TDT4295AForEffort/pcb/components/crystal/CX3225SB48000D0FFFCC.step

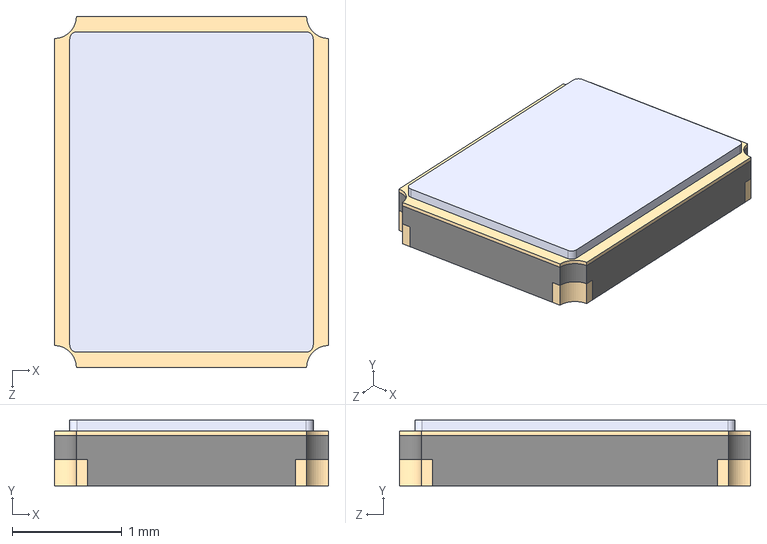
[picture p1: CAD file, 2022-09-29]
components/crystal/CX3225SB48000D0FFFCC.step
2.50 x 0.6 x 3.20 mm
