TDT4295AForEffort/pcb/components/debug_header/FTSH-110-01-L-DV-007.step

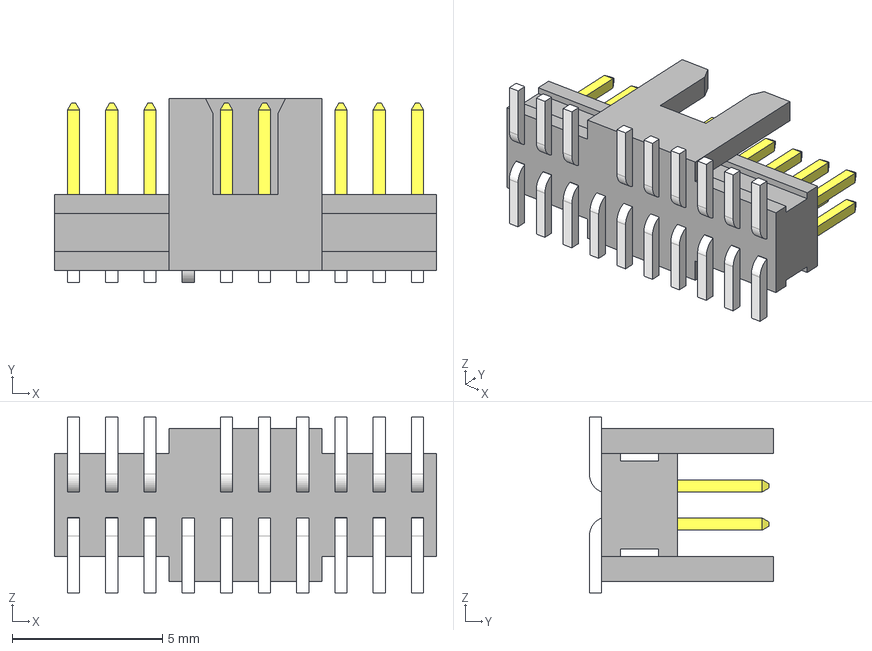
[picture p2: CAD file, 2022-09-29]
components/debug_header/FTSH-110-01-L-DV-007.step
12.7 x 6.12 x 5.84 mm
FTSH-110-01-L-DV-007-K_pins2
FTSH-110-01-L-DV-007-K_pins1
FTSH-110-01-L-DV-007-K_body
