TDT4295AForEffort/pcb/pcb/pcb.kicad_pcb

## KiCad design pcb/pcb.kicad_pcb (2022-10-04)

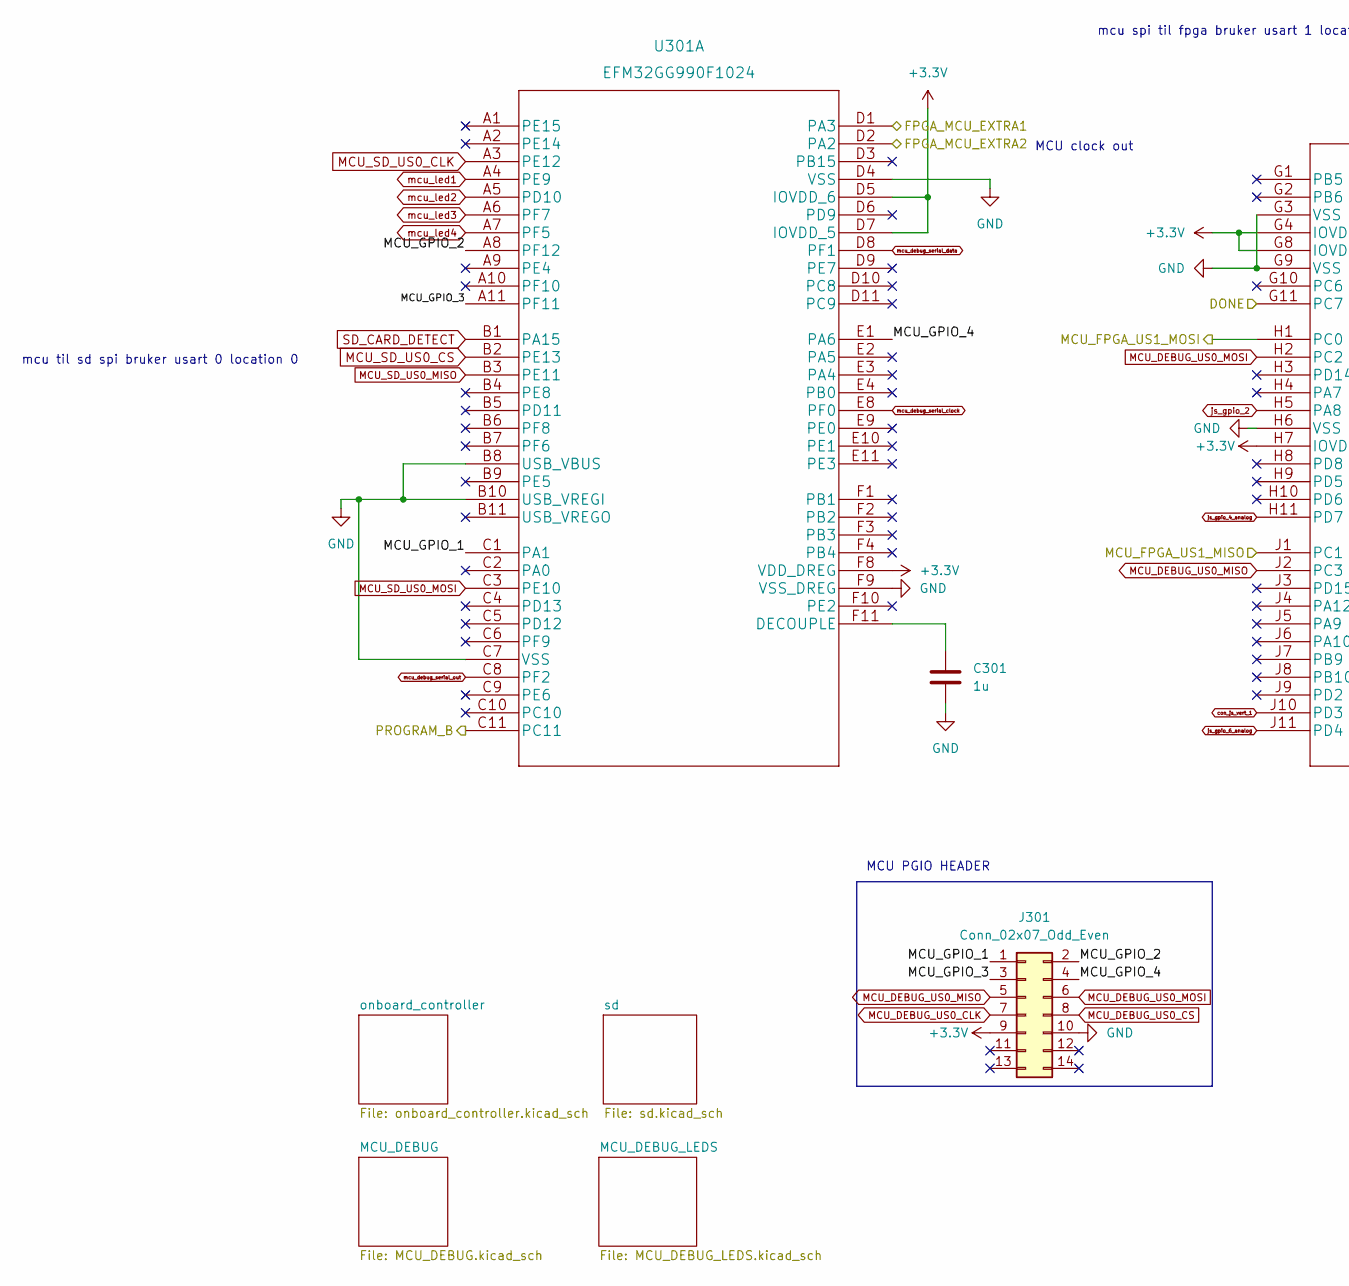
[picture p3: schematic mcu.kicad_sch, part in row 1, column 1]

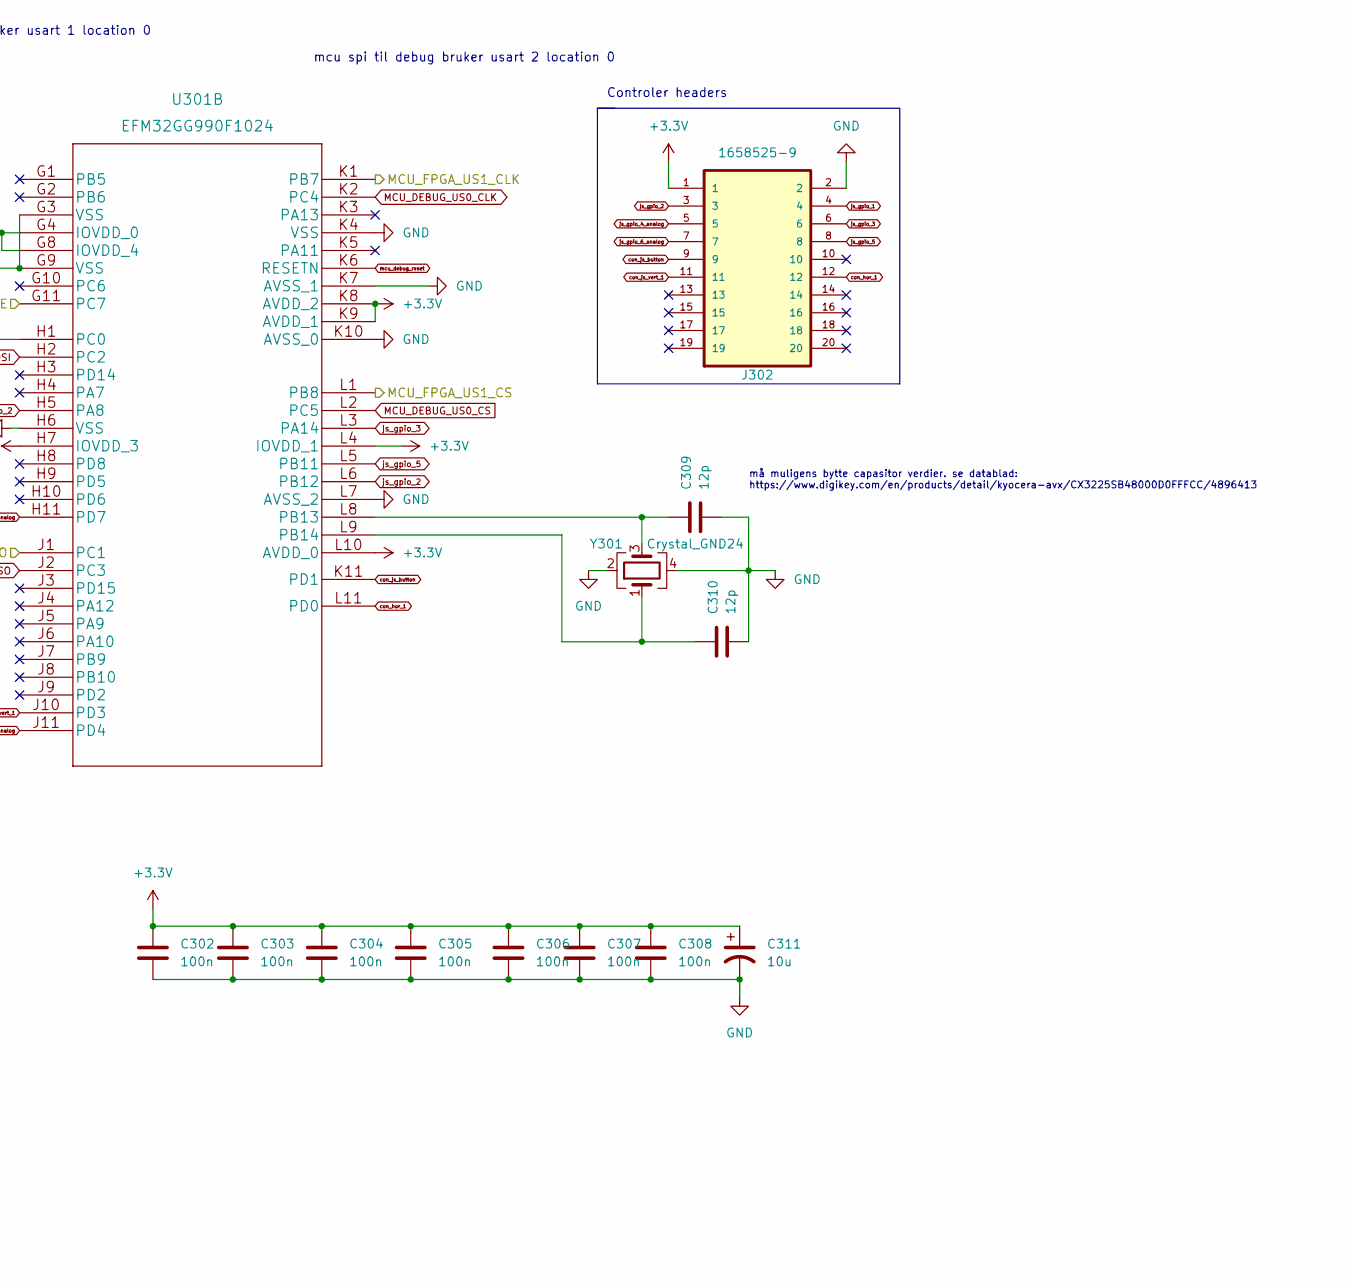
[picture p4: schematic mcu.kicad_sch, part in row 1, column 2]

Parts:
C301: 1u; C_0805_2012Metric_Pad1.18x1.45mm_HandSolder
C302, C303, C304, C305, C306, C307, C308: 100n; C_0805_2012Metric_Pad1.18x1.45mm_HandSolder
C309, C310: 12p; C_0603_1608Metric_Pad1.08x0.95mm_HandSolder
C311: 10u; C_0805_2012Metric_Pad1.18x1.45mm_HandSolder
J301: Conn_02x07_Odd_Even; PinHeader_2x07_P2.54mm_Vertical
J302: 1658525-9; TE_1658525-9
U301: EFM32GG990F1024
Y301: Crystal_GND24; OSC_ECS-2520S25-250-FN-TR

Connections:
+3.3V: C302.1, C303.1, C304.1, C305.1, C306.1, C307.1, C308.1, C311.1, J301.9, J302.1, U301.D5 (IOVDD_6), U301.D7 (IOVDD_5), U301.F8 (VDD_DREG), U301.G4 (IOVDD_0), U301.G8 (IOVDD_4), U301.H7 (IOVDD_3), U301.K8 (AVDD_2), U301.K9 (AVDD_1), U301.L4 (IOVDD_1), U301.L10 (AVDD_0); also elsewhere on the board
/Mcu/MCU_GPIO_1: J301.1, U301.C1 (PA1)
/Mcu/MCU_GPIO_2: J301.2, U301.A8 (PF12)
/Mcu/MCU_GPIO_3: J301.3, U301.A11 (PF11)
/Mcu/MCU_GPIO_4: J301.4, U301.E1 (PA6)
FGPA_MCU_EXTRA1: U301.D1 (PA3); also elsewhere on the board
FGPA_MCU_EXTRA2: U301.D2 (PA2); also elsewhere on the board
FGPA_MCU_SPI_CLK: U301.K1 (PB7); also elsewhere on the board
FGPA_MCU_SPI_CS: U301.L1 (PB8); also elsewhere on the board
FGPA_MCU_SPI_SDI: U301.H1 (PC0); also elsewhere on the board
FGPA_MCU_SPI_SDO: U301.J1 (PC1); also elsewhere on the board
FPGA_DONE: U301.G11 (PC7); also elsewhere on the board
FPGA_PROGRAM_B: U301.C11; also elsewhere on the board
GND: C301.2, C302.2, C303.2, C304.2, C305.2, C306.2, C307.2, C308.2, C309.2, C310.2, C311.2, J301.10, J302.2, U301.B8 (USB_VBUS), U301.B10 (USB_VREGI), U301.C7 (VSS), U301.D4 (VSS), U301.F9 (VSS_DREG), U301.G3 (VSS), U301.G9 (VSS), U301.H6 (VSS), U301.K4 (VSS), U301.K7 (AVSS_1), U301.K10 (AVSS_0), U301.L7 (AVSS_2), Y301.2, Y301.4; also elsewhere on the board
MCU_DEBUG_US0_CLK: J301.7, U301.K2 (PC4)
MCU_DEBUG_US0_CS: J301.8, U301.L2 (PC5)
MCU_DEBUG_US0_MISO: J301.5, U301.J2 (PC3)
MCU_DEBUG_US0_MOSI: J301.6, U301.H2 (PC2)
MCU_SD_US0_CLK: U301.A3 (PE12); also elsewhere on the board
MCU_SD_US0_CS: U301.B2 (PE13); also elsewhere on the board
MCU_SD_US0_MISO: U301.B3 (PE11); also elsewhere on the board
MCU_SD_US0_MOSI: U301.C3 (PE10); also elsewhere on the board
unnamed: C301.1, U301.F11 (DECOUPLE)
unnamed: C309.1, U301.L8 (PB13), Y301.3
unnamed: C310.1, U301.L9 (PB14), Y301.1
SD_CARD_DETECT: U301.B1 (PA15); also elsewhere on the board
con_hor_1: J302.12, U301.L11 (PD0)
con_js_button: J302.9, U301.K11 (PD1)
con_js_vert_1: J302.11, U301.J10 (PD3)
js_gpio_3: J302.6, U301.L3 (PA14)
js_gpio_4_analog: J302.5, U301.H11 (PD7)
js_gpio_5: J302.8, U301.L5 (PB11)
js_gpio_6_analog: J302.7, U301.J11 (PD4)
mcu_debug_reset: U301.K6 (RESETN); also elsewhere on the board
mcu_debug_serial_clock: U301.E8 (PF0); also elsewhere on the board
mcu_debug_serial_data: U301.D8 (PF1); also elsewhere on the board
mcu_debug_serial_out: U301.C8 (PF2); also elsewhere on the board
mcu_led1: U301.A4 (PE9); also elsewhere on the board
mcu_led2: U301.A5 (PD10); also elsewhere on the board
mcu_led3: U301.A6 (PF7); also elsewhere on the board
mcu_led4: U301.A7 (PF5); also elsewhere on the board

Notes on the sheet:
mcu til sd spi bruker usart 0 location 0
MCU PGIO HEADER
mcu spi til debug bruker usart 2 location 0
Controler headers
må muligens bytte capasitor verdier. se datablad: https://www.digikey.com/en/products/detail/kyocera-avx/CX3225SB48000D0FFFCC/4896413
MCU clock out
mcu spi til fpga bruker usart 1 location 0

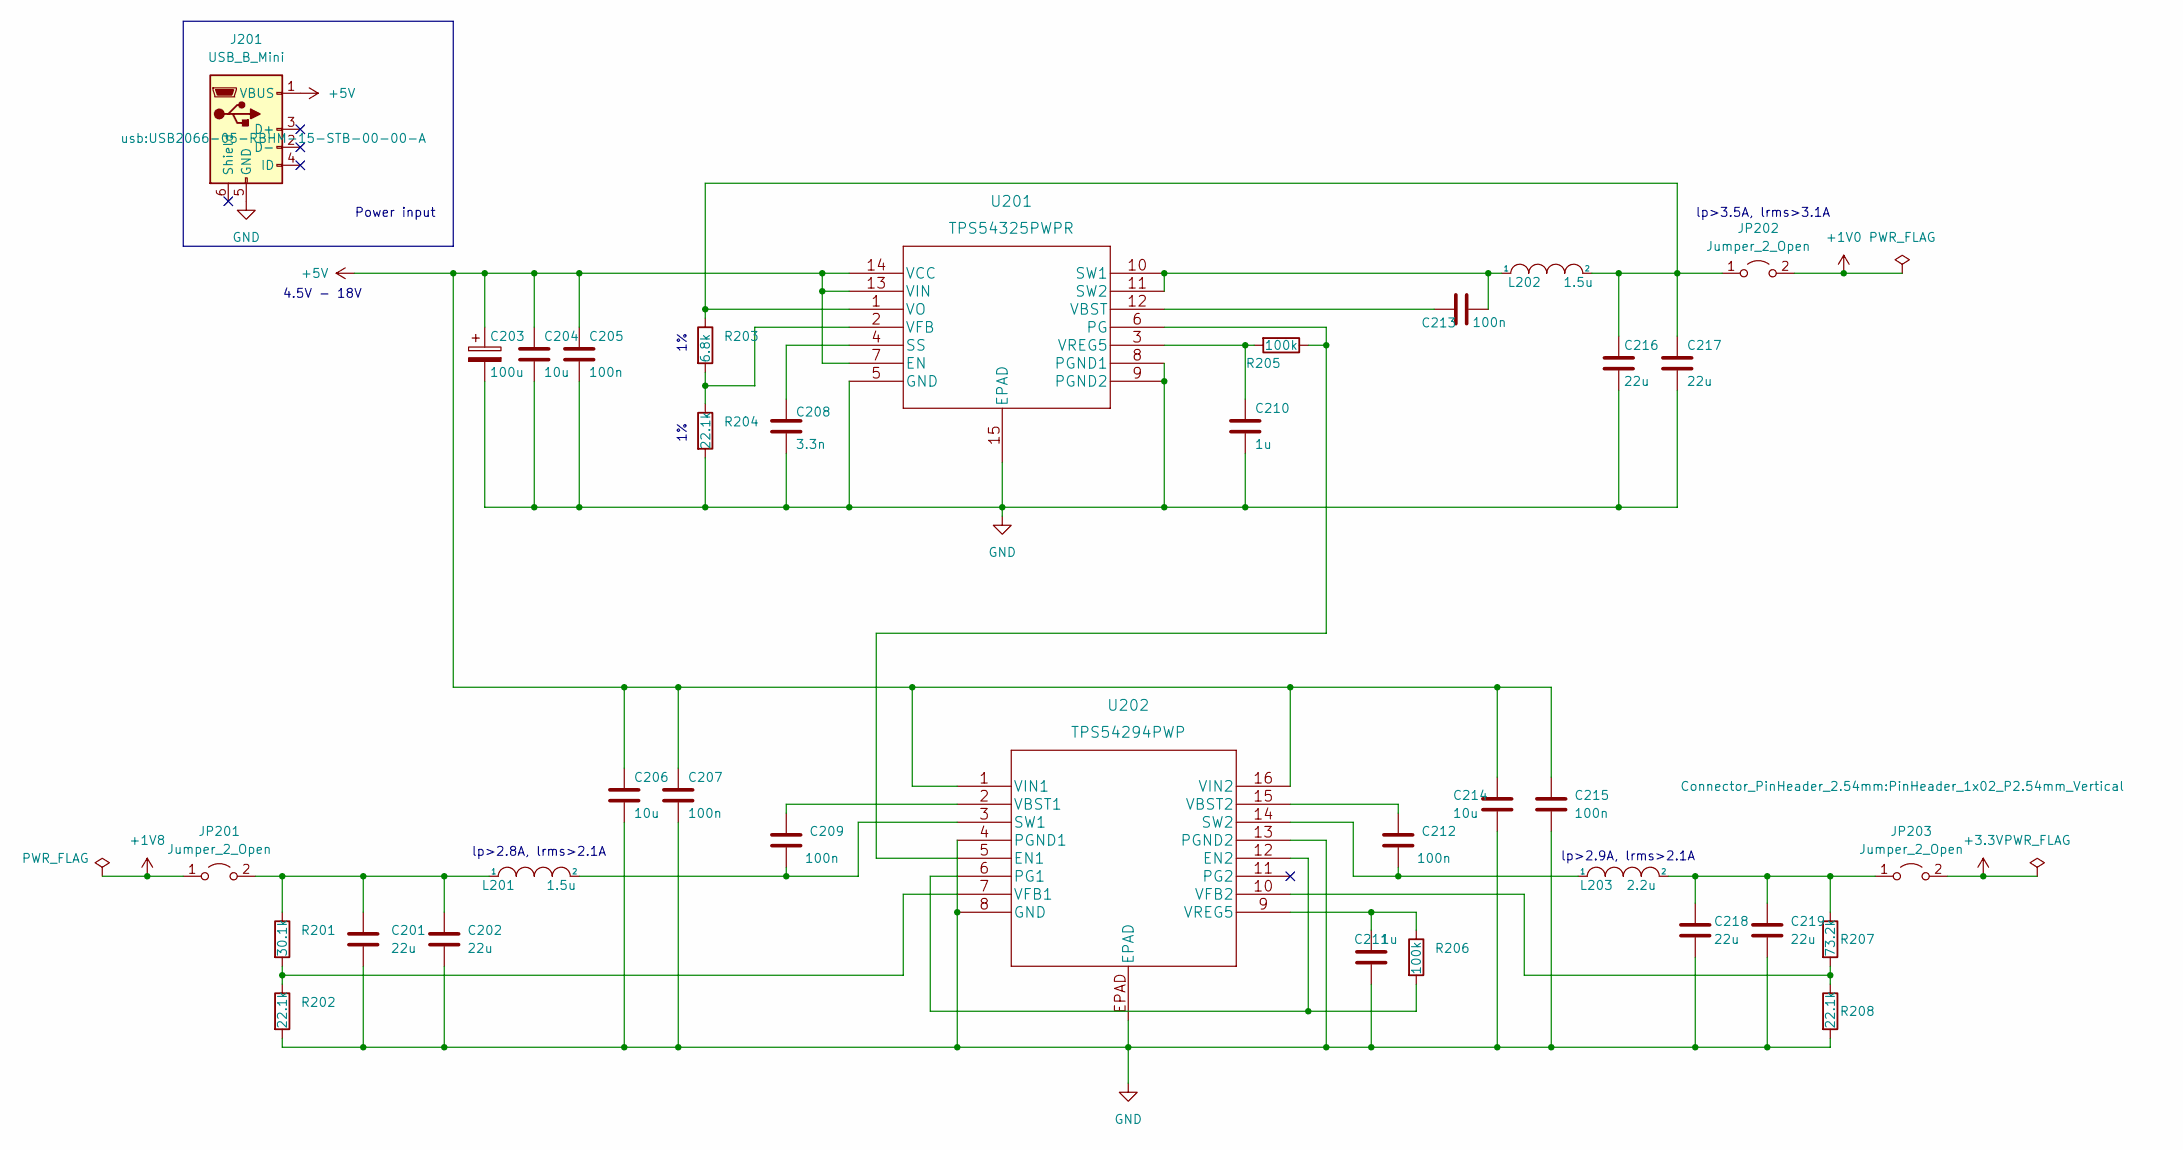
[picture p5: schematic psu.kicad_sch]

Parts:
C201, C202, C216, C217, C218, C219: 22u; C_0805_2012Metric_Pad1.18x1.45mm_HandSolder
C203: 100u; C_1210_3225Metric_Pad1.33x2.70mm_HandSolder
C204, C206, C214: 10u; C_0805_2012Metric_Pad1.18x1.45mm_HandSolder
C205, C207, C209, C212, C213, C215: 100n; C_0805_2012Metric_Pad1.18x1.45mm_HandSolder
C208: 3.3n; C_0805_2012Metric_Pad1.18x1.45mm_HandSolder
C210, C211: 1u; C_0805_2012Metric_Pad1.18x1.45mm_HandSolder
J201: USB_B_Mini; USB2066-05-RBHM-15-STB-00-00-A
JP201, JP202, JP203: Jumper_2_Open; PinHeader_1x02_P2.54mm_Vertical
L201, L202: 1.5u; L_1210_3225Metric_Pad1.42x2.65mm_HandSolder
L203: 2.2u; L_1210_3225Metric_Pad1.42x2.65mm_HandSolder
R201: 30.1k; R_0805_2012Metric_Pad1.20x1.40mm_HandSolder
R202, R204, R208: 22.1k; R_0805_2012Metric_Pad1.20x1.40mm_HandSolder
R203: 6.8k; R_0805_2012Metric_Pad1.20x1.40mm_HandSolder
R205, R206: 100k; R_0805_2012Metric_Pad1.20x1.40mm_HandSolder
R207: 73.2k; R_0805_2012Metric_Pad1.20x1.40mm_HandSolder
U201: TPS54325PWPR
U202: TPS54294PWP

Connections:
+1V0: JP202.2 (B); also elsewhere on the board
+1V8: JP201.1 (A); also elsewhere on the board
+3.3V: JP203.2 (B); also elsewhere on the board
+5V: C203.1, C204.1, C205.1, C206.1, C207.1, C214.1, C215.1, J201.1 (VBUS), U201.7 (EN), U201.13 (VIN), U201.14 (VCC), U202.1 (VIN1), U202.16 (VIN2)
GND: C201.2, C202.2, C203.2, C204.2, C205.2, C206.2, C207.2, C208.2, C210.2, C211.2, C214.2, C215.2, C216.2, C217.2, C218.2, C219.2, J201.5 (GND), R202.2, R204.2, R208.2, U201.5 (GND), U201.8 (PGND1), U201.9 (PGND2), U201.15 (EPAD), U202.4 (PGND1), U202.8 (GND), U202.13 (PGND2), U202.EPAD, U202.V; also elsewhere on the board
unnamed: C201.1, C202.1, JP201.2 (B), L201.1, R201.1
unnamed: C208.1, U201.4 (SS)
unnamed: C209.1, U202.2 (VBST1)
unnamed: C209.2, L201.2, U202.3 (SW1)
unnamed: C210.1, R205.2, U201.3 (VREG5)
unnamed: C211.1, R206.1, U202.9 (VREG5)
unnamed: C212.1, U202.15 (VBST2)
unnamed: C212.2, L203.1, U202.14 (SW2)
unnamed: C213.1, U201.12 (VBST)
unnamed: C213.2, L202.1, U201.10 (SW1), U201.11 (SW2)
unnamed: C216.1, C217.1, JP202.1 (A), L202.2, R203.1, U201.1 (VO)
unnamed: C218.1, C219.1, JP203.1 (A), L203.2, R207.1
unnamed: R201.2, R202.1, U202.7 (VFB1)
unnamed: R203.2, R204.1, U201.2 (VFB)
unnamed: R205.1, U201.6 (PG), U202.5 (EN1)
unnamed: R206.2, U202.6 (PG1), U202.12 (EN2)
unnamed: R207.2, R208.1, U202.10 (VFB2)

Notes on the sheet:
lp>3.5A, lrms>3.1A
4.5V - 18V
lp>2.9A, lrms>2.1A
Power input
lp>2.8A, lrms>2.1A

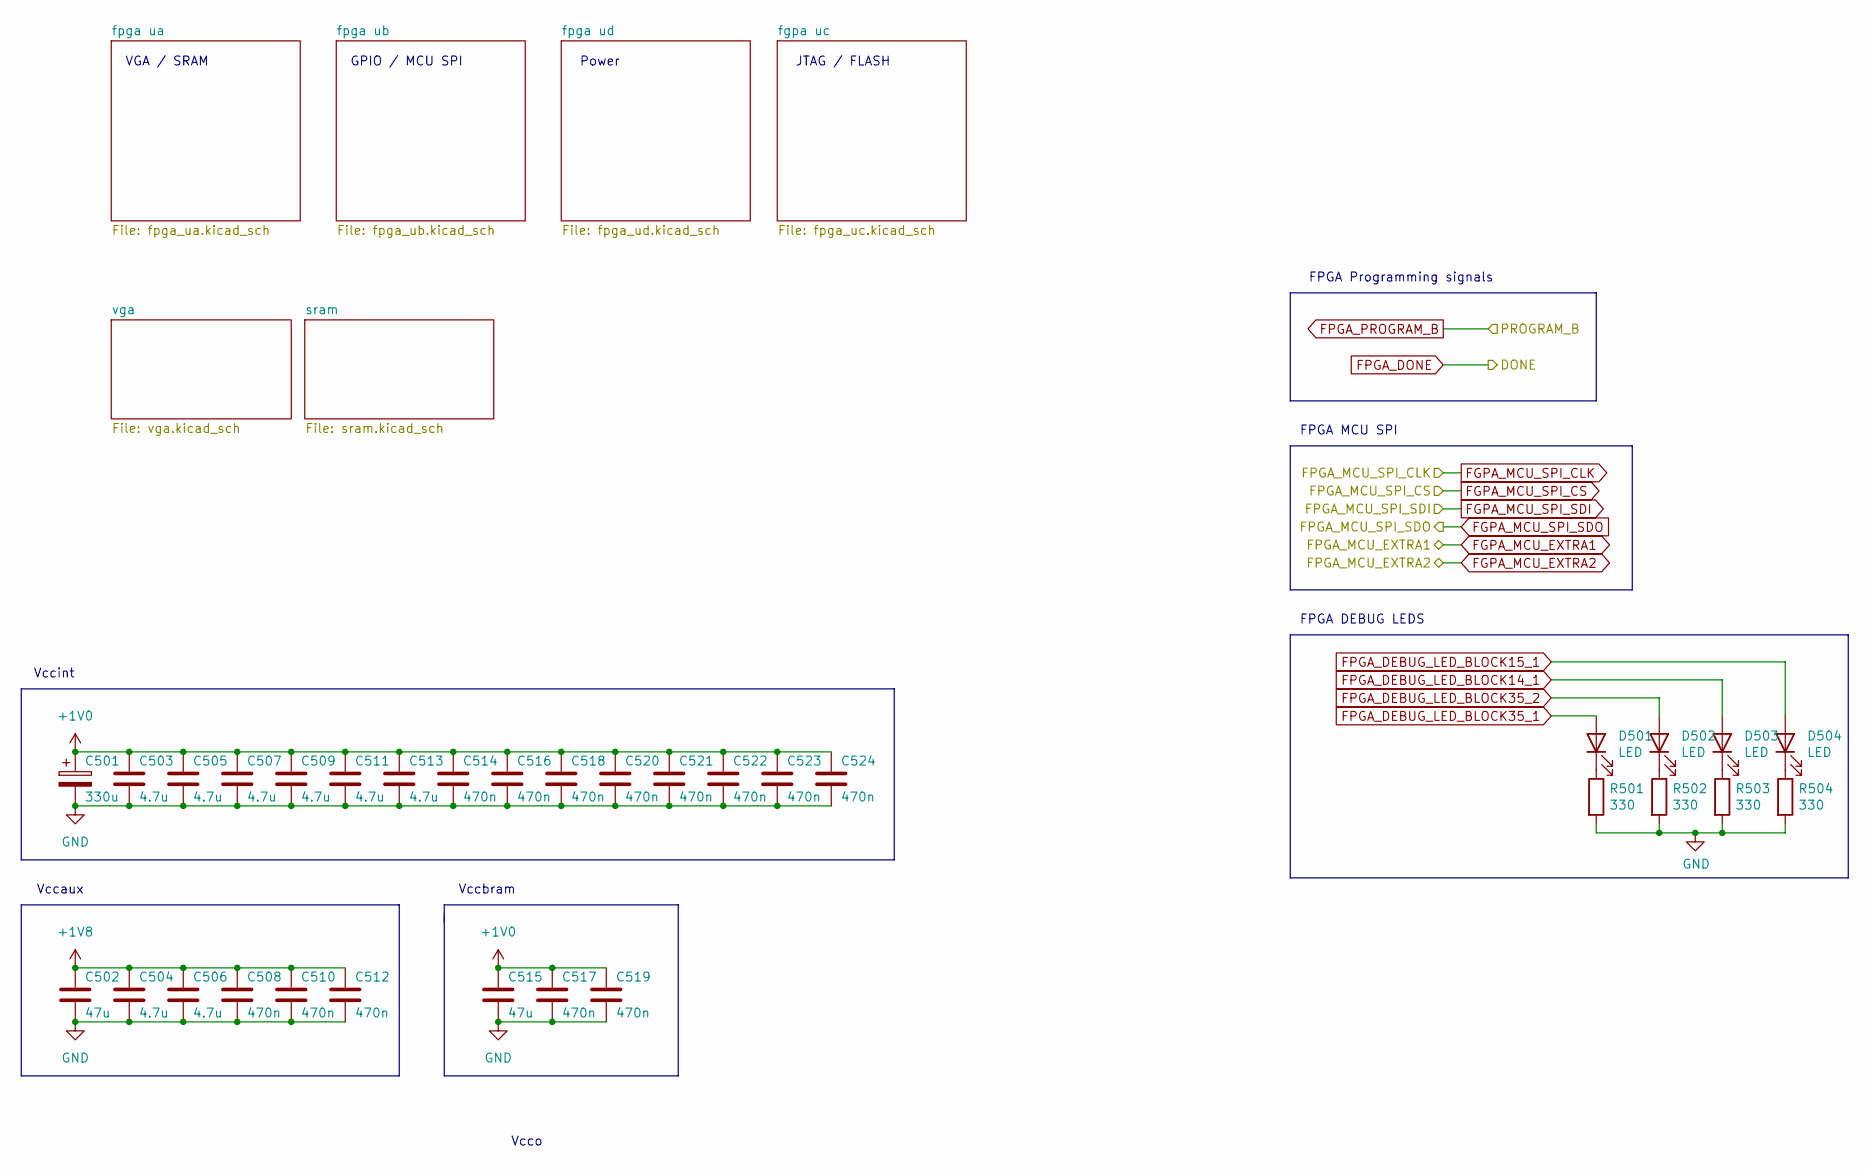
[picture p6: schematic fpga.kicad_sch]

Parts:
C501: 330u; T520V337M2R5ATE025
C502, C515: 47u; C_1210_3225Metric_Pad1.33x2.70mm_HandSolder
C503, C504, C505, C506, C507, C509, C511, C513: 4.7u; C_0805_2012Metric_Pad1.18x1.45mm_HandSolder
C508, C510, C512, C514, C516, C517, C518, C519, C520, C521, C522, C523, C524: 470n; C_0603_1608Metric_Pad1.08x0.95mm_HandSolder
D501, D502, D503, D504: LED; LED_1206_3216Metric_Pad1.42x1.75mm_HandSolder
R501, R502, R503, R504: 330; R_0805_2012Metric_Pad1.20x1.40mm_HandSolder

Connections:
+1V0: C501.1, C503.1, C505.1, C507.1, C509.1, C511.1, C513.1, C514.1, C515.1, C516.1, C517.1, C518.1, C519.1, C520.1, C521.1, C522.1, C523.1, C524.1; also elsewhere on the board
+1V8: C502.1, C504.1, C506.1, C508.1, C510.1, C512.1; also elsewhere on the board
FPGA_DEBUG_LED_BLOCK14_1: D503.2 (A); also elsewhere on the board
FPGA_DEBUG_LED_BLOCK15_1: D504.2 (A); also elsewhere on the board
FPGA_DEBUG_LED_BLOCK35_1: D501.2 (A); also elsewhere on the board
FPGA_DEBUG_LED_BLOCK35_2: D502.2 (A); also elsewhere on the board
GND: C501.2, C502.2, C503.2, C504.2, C505.2, C506.2, C507.2, C508.2, C509.2, C510.2, C511.2, C512.2, C513.2, C514.2, C515.2, C516.2, C517.2, C518.2, C519.2, C520.2, C521.2, C522.2, C523.2, C524.2, R501.2, R502.2, R503.2, R504.2; also elsewhere on the board
unnamed: D501.1 (K), R501.1
unnamed: D502.1 (K), R502.1
unnamed: D503.1 (K), R503.1
unnamed: D504.1 (K), R504.1

Notes on the sheet:
FPGA Programming signals
Vccint
Power
Vccaux
Vcco
FPGA MCU SPI
JTAG / FLASH
GPIO / MCU SPI
Vccbram
VGA / SRAM
FPGA DEBUG LEDS

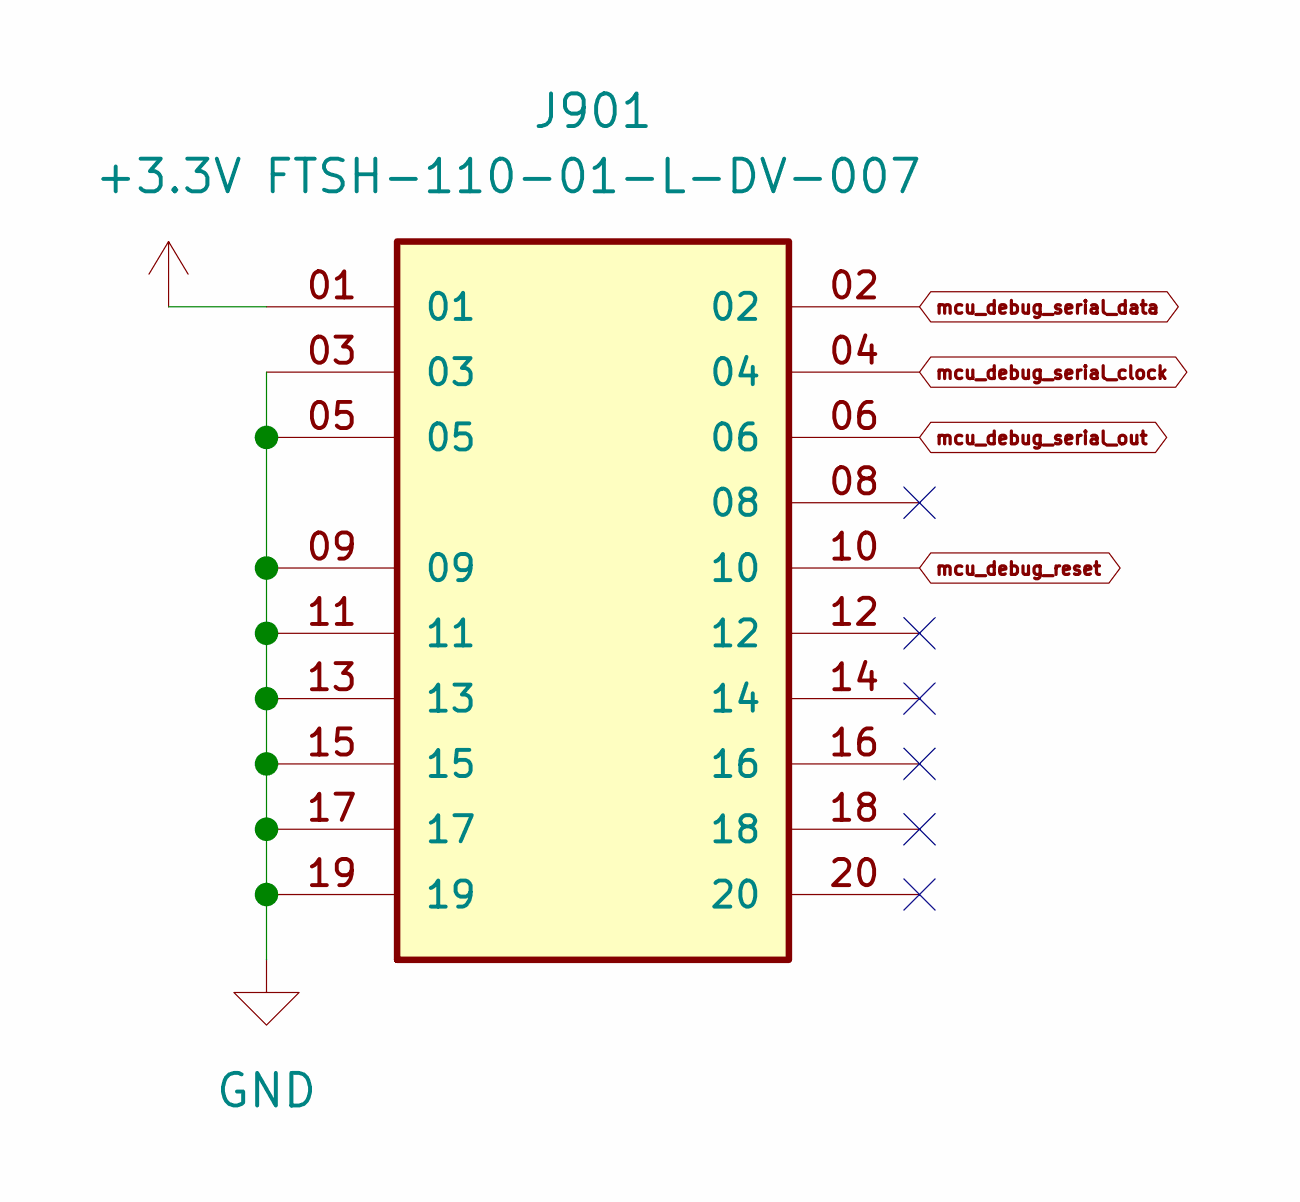
[picture p7: schematic MCU_DEBUG.kicad_sch]

Parts:
J901: FTSH-110-01-L-DV-007; SAMTEC_FTSH-110-01-L-DV-007; PARTREV R

Connections:
+3.3V: J901.01; also elsewhere on the board
GND: J901.03, J901.05, J901.09, J901.11, J901.13, J901.15, J901.17, J901.19; also elsewhere on the board
mcu_debug_reset: J901.10; also elsewhere on the board
mcu_debug_serial_clock: J901.04; also elsewhere on the board
mcu_debug_serial_data: J901.02; also elsewhere on the board
mcu_debug_serial_out: J901.06; also elsewhere on the board

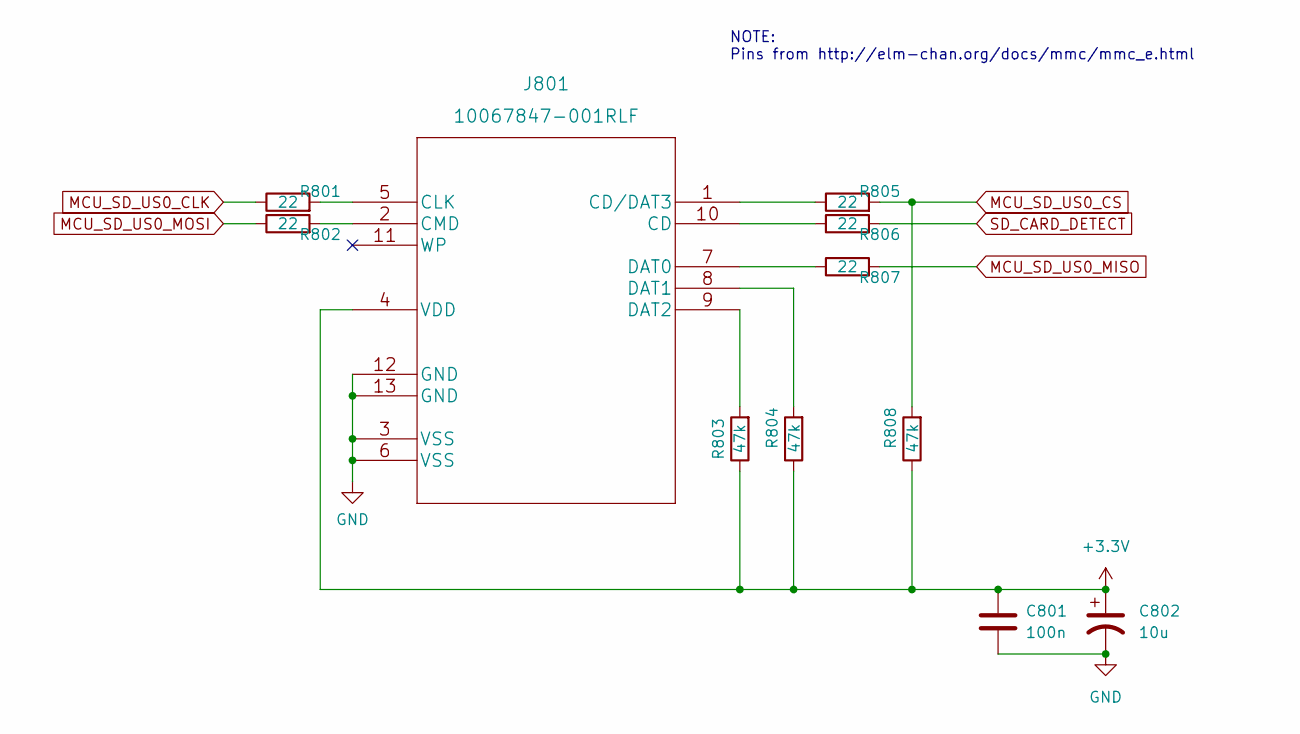
[picture p8: schematic sd.kicad_sch]

Parts:
C801: 100n; C_0805_2012Metric_Pad1.18x1.45mm_HandSolder
C802: 10u; C_0805_2012Metric_Pad1.18x1.45mm_HandSolder
J801: 10067847-001RLF
R801, R802, R805, R806, R807: 22; R_0805_2012Metric_Pad1.20x1.40mm_HandSolder
R803, R804, R808: 47k; R_0805_2012Metric_Pad1.20x1.40mm_HandSolder

Connections:
+3.3V: C801.1, C802.1, J801.4 (VDD), R803.1, R804.1, R808.1; also elsewhere on the board
GND: C801.2, C802.2, J801.3 (VSS), J801.6 (VSS), J801.12 (GND), J801.13 (GND); also elsewhere on the board
MCU_SD_US0_CLK: R801.1; also elsewhere on the board
MCU_SD_US0_CS: R805.2, R808.2; also elsewhere on the board
MCU_SD_US0_MISO: R807.2; also elsewhere on the board
MCU_SD_US0_MOSI: R802.1; also elsewhere on the board
unnamed: J801.1 (CD/DAT3), R805.1
unnamed: J801.2 (CMD), R802.2
unnamed: J801.5 (CLK), R801.2
unnamed: J801.7 (DAT0), R807.1
unnamed: J801.8 (DAT1), R804.2
unnamed: J801.9 (DAT2), R803.2
unnamed: J801.10 (CD), R806.1
SD_CARD_DETECT: R806.2; also elsewhere on the board

Notes on the sheet:
NOTE: Pins from http://elm-chan.org/docs/mmc/mmc_e.html

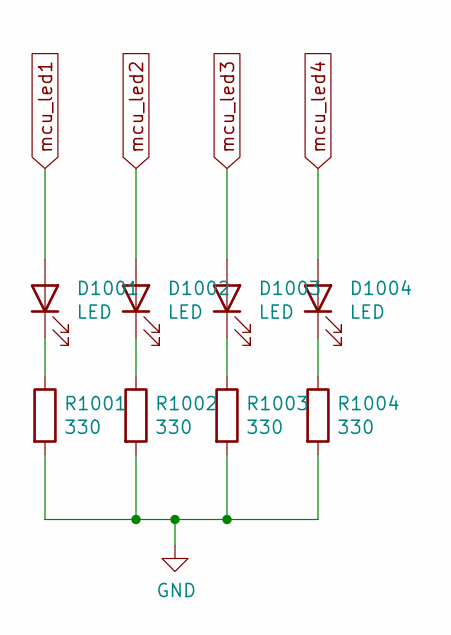
[picture p9: schematic MCU_DEBUG_LEDS.kicad_sch]

Parts:
D1001, D1002, D1003, D1004: LED; LED_1206_3216Metric_Pad1.42x1.75mm_HandSolder
R1001, R1002, R1003, R1004: 330; R_0805_2012Metric_Pad1.20x1.40mm_HandSolder

Connections:
GND: R1001.2, R1002.2, R1003.2, R1004.2; also elsewhere on the board
unnamed: D1001.1 (K), R1001.1
unnamed: D1002.1 (K), R1002.1
unnamed: D1003.1 (K), R1003.1
unnamed: D1004.1 (K), R1004.1
mcu_led1: D1001.2 (A); also elsewhere on the board
mcu_led2: D1002.2 (A); also elsewhere on the board
mcu_led3: D1003.2 (A); also elsewhere on the board
mcu_led4: D1004.2 (A); also elsewhere on the board

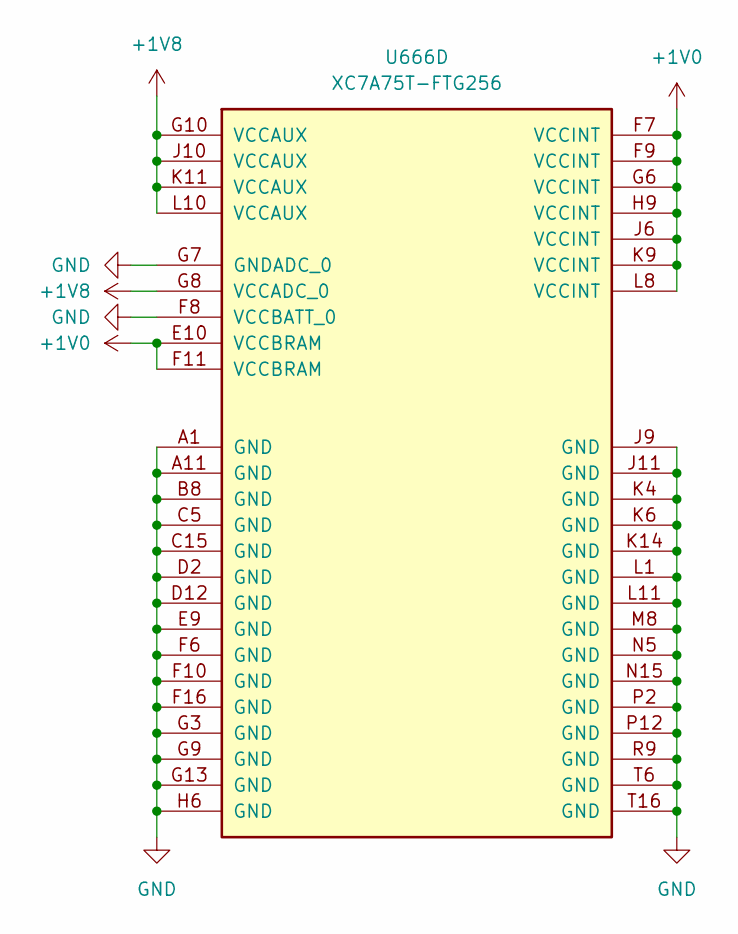
[picture p10: schematic fpga_ud.kicad_sch]

Parts:
U666: XC7A75T-FTG256; Xilinx_FTG256

Connections:
+1V0: U666.E10 (VCCBRAM), U666.F7 (VCCINT), U666.F9 (VCCINT), U666.F11 (VCCBRAM), U666.G6 (VCCINT), U666.H9 (VCCINT), U666.J6 (VCCINT), U666.K9 (VCCINT), U666.L8 (VCCINT); also elsewhere on the board
+1V8: U666.G8 (VCCADC_0), U666.G10 (VCCAUX), U666.J10 (VCCAUX), U666.K11 (VCCAUX), U666.L10 (VCCAUX); also elsewhere on the board
GND: U666.A1 (GND), U666.A11 (GND), U666.B8 (GND), U666.C5 (GND), U666.C15 (GND), U666.D2 (GND), U666.D12 (GND), U666.E9 (GND), U666.F6 (GND), U666.F8 (VCCBATT_0), U666.F10 (GND), U666.F16 (GND), U666.G3 (GND), U666.G7 (GNDADC_0), U666.G9 (GND), U666.G13 (GND), U666.H6 (GND), U666.J9 (GND), U666.J11 (GND), U666.K4 (GND), U666.K6 (GND), U666.K14 (GND), U666.L1 (GND), U666.L11 (GND), U666.M8 (GND), U666.N5 (GND), U666.N15 (GND), U666.P2 (GND), U666.P12 (GND), U666.R9 (GND), U666.T6 (GND), U666.T16 (GND); also elsewhere on the board

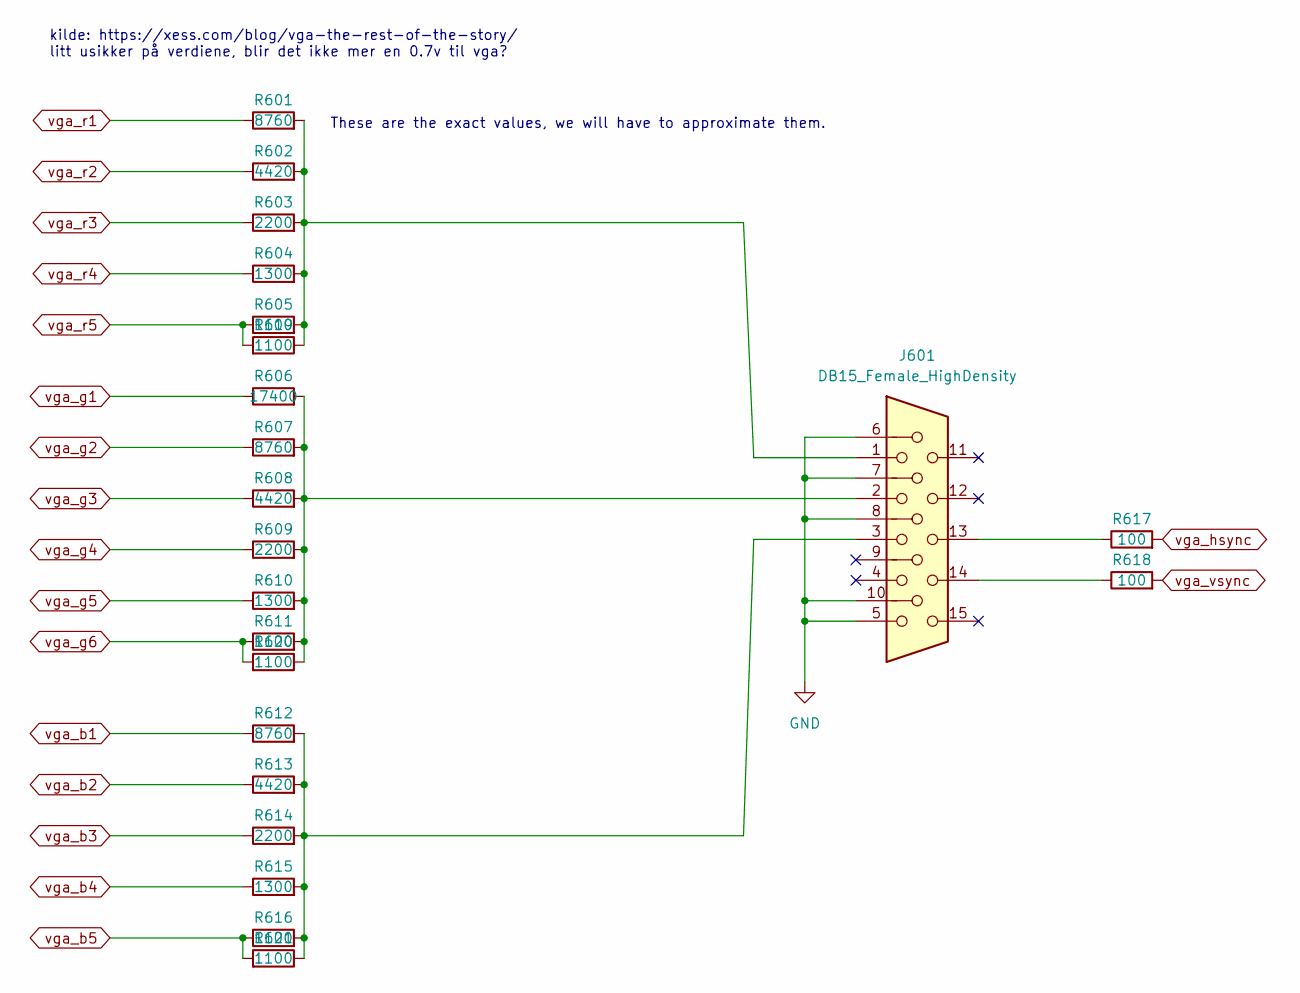
[picture p11: schematic vga.kicad_sch]

Parts:
J601: DB15_Female_HighDensity; AHDF15A-KG-TAXB
R601, R607, R612: 8760; R_0805_2012Metric_Pad1.20x1.40mm_HandSolder
R602, R608, R613: 4420; R_0603_1608Metric_Pad0.98x0.95mm_HandSolder
R603, R609, R614: 2200; R_0603_1608Metric_Pad0.98x0.95mm_HandSolder
R604, R610, R615: 1300; R_0603_1608Metric_Pad0.98x0.95mm_HandSolder
R605, R611, R616, R619, R620, R621: 1100; R_0603_1608Metric_Pad0.98x0.95mm_HandSolder
R606: 17400; R_0603_1608Metric_Pad0.98x0.95mm_HandSolder
R617, R618: 100; R_0805_2012Metric_Pad1.20x1.40mm_HandSolder

Connections:
GND: J601.5, J601.6, J601.7, J601.8, J601.10; also elsewhere on the board
unnamed: J601.1, R601.2, R602.2, R603.2, R604.2, R605.2, R619.1
unnamed: J601.2, R606.2, R607.2, R608.2, R609.2, R610.2, R611.2, R620.1
unnamed: J601.3, R612.2, R613.2, R614.2, R615.2, R616.2, R621.1
unnamed: J601.13, R617.1
unnamed: J601.14, R618.1
vga_b1: R612.1; also elsewhere on the board
vga_b2: R613.1; also elsewhere on the board
vga_b3: R614.1; also elsewhere on the board
vga_b4: R615.1; also elsewhere on the board
vga_b5: R616.1, R621.2; also elsewhere on the board
vga_g1: R606.1; also elsewhere on the board
vga_g2: R607.1; also elsewhere on the board
vga_g3: R608.1; also elsewhere on the board
vga_g4: R609.1; also elsewhere on the board
vga_g5: R610.1; also elsewhere on the board
vga_g6: R611.1, R620.2; also elsewhere on the board
vga_hsync: R617.2; also elsewhere on the board
vga_r1: R601.1; also elsewhere on the board
vga_r2: R602.1; also elsewhere on the board
vga_r3: R603.1; also elsewhere on the board
vga_r4: R604.1; also elsewhere on the board
vga_r5: R605.1, R619.2; also elsewhere on the board
vga_vsync: R618.2; also elsewhere on the board

Notes on the sheet:
These are the exact values, we will have to approximate them.
kilde: https://xess.com/blog/vga-the-rest-of-the-story/ litt usikker på verdiene, blir det ikke mer en 0.7v til vga?

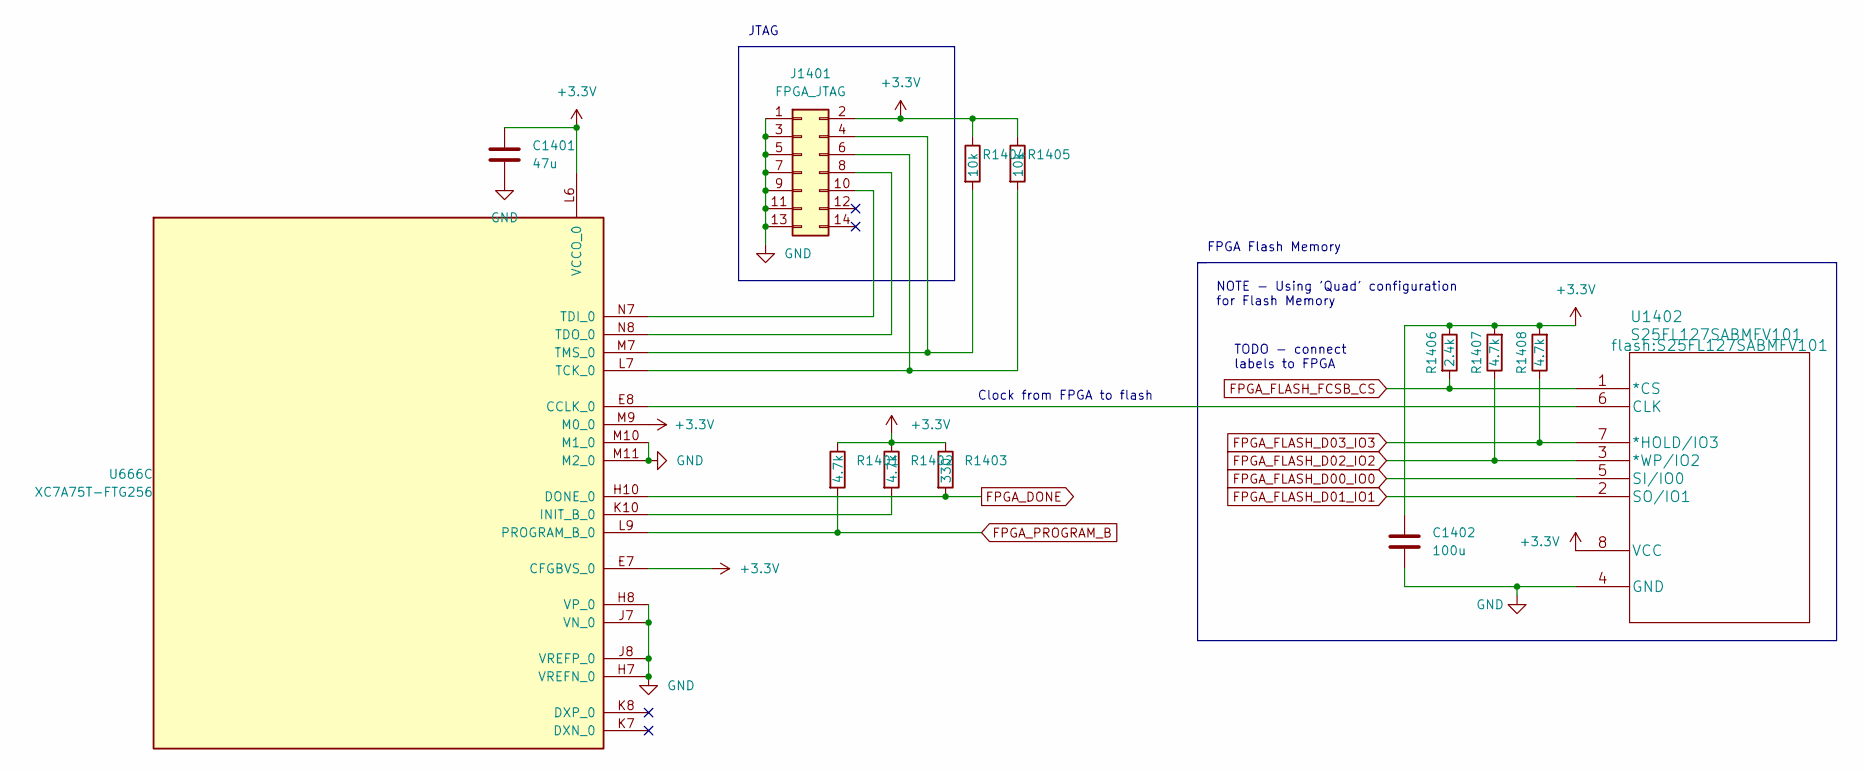
[picture p12: schematic fpga_uc.kicad_sch]

Parts:
C1401: 47u; C_1210_3225Metric_Pad1.33x2.70mm_HandSolder
C1402: 100u; C_1210_3225Metric_Pad1.33x2.70mm_HandSolder
J1401: FPGA_JTAG; PinHeader_2x07_P2.54mm_Vertical
R1401, R1402, R1407, R1408: 4.7k; R_0805_2012Metric_Pad1.20x1.40mm_HandSolder
R1403: 330; R_0805_2012Metric_Pad1.20x1.40mm_HandSolder
R1404, R1405: 10k; R_0805_2012Metric_Pad1.20x1.40mm_HandSolder
R1406: 2.4k; R_0805_2012Metric_Pad1.20x1.40mm_HandSolder
U666: XC7A75T-FTG256; Xilinx_FTG256
U1402: S25FL127SABMFV101

Connections:
+3.3V: C1401.1, C1402.1, J1401.2, R1401.1, R1402.1, R1403.1, R1404.1, R1405.1, R1406.1, R1407.2, R1408.2, U666.E7 (CFGBVS_0), U666.L6 (VCCO_0), U666.M9 (M0_0), U1402.8 (VCC); also elsewhere on the board
FPGA_DONE: R1403.2, U666.H10 (DONE_0); also elsewhere on the board
FPGA_FLASH_D00_IO0: U1402.5 (SI/IO0); also elsewhere on the board
FPGA_FLASH_D01_IO1: U1402.2 (SO/IO1); also elsewhere on the board
FPGA_FLASH_D02_IO2: R1407.1, U1402.3 (*WP/IO2); also elsewhere on the board
FPGA_FLASH_D03_IO3: R1408.1, U1402.7 (*HOLD/IO3); also elsewhere on the board
FPGA_FLASH_FCSB_CS: R1406.2, U1402.1 (*CS); also elsewhere on the board
FPGA_PROGRAM_B: R1401.2, U666.L9 (PROGRAM_B_0); also elsewhere on the board
GND: C1401.2, C1402.2, J1401.1, J1401.3, J1401.5, J1401.7, J1401.9, J1401.11, J1401.13, U666.H7 (VREFN_0), U666.H8 (VP_0), U666.J7 (VN_0), U666.J8 (VREFP_0), U666.M10 (M1_0), U666.M11 (M2_0), U1402.4 (GND); also elsewhere on the board
unnamed: J1401.4, R1404.2, U666.M7 (TMS_0)
unnamed: J1401.6, R1405.2, U666.L7 (TCK_0)
unnamed: J1401.8, U666.N8 (TDO_0)
unnamed: J1401.10, U666.N7 (TDI_0)
unnamed: R1402.2, U666.K10 (INIT_B_0)
unnamed: U666.E8 (CCLK_0), U1402.6 (CLK)

Notes on the sheet:
Clock from FPGA to flash
FPGA Flash Memory
TODO - connect labels to FPGA
JTAG
NOTE - Using 'Quad' configuration for Flash Memory
