TDT4295AForEffort/pcb/pcb/pcb.kicad_pcb

## KiCad design pcb/pcb.kicad_pcb (continued)

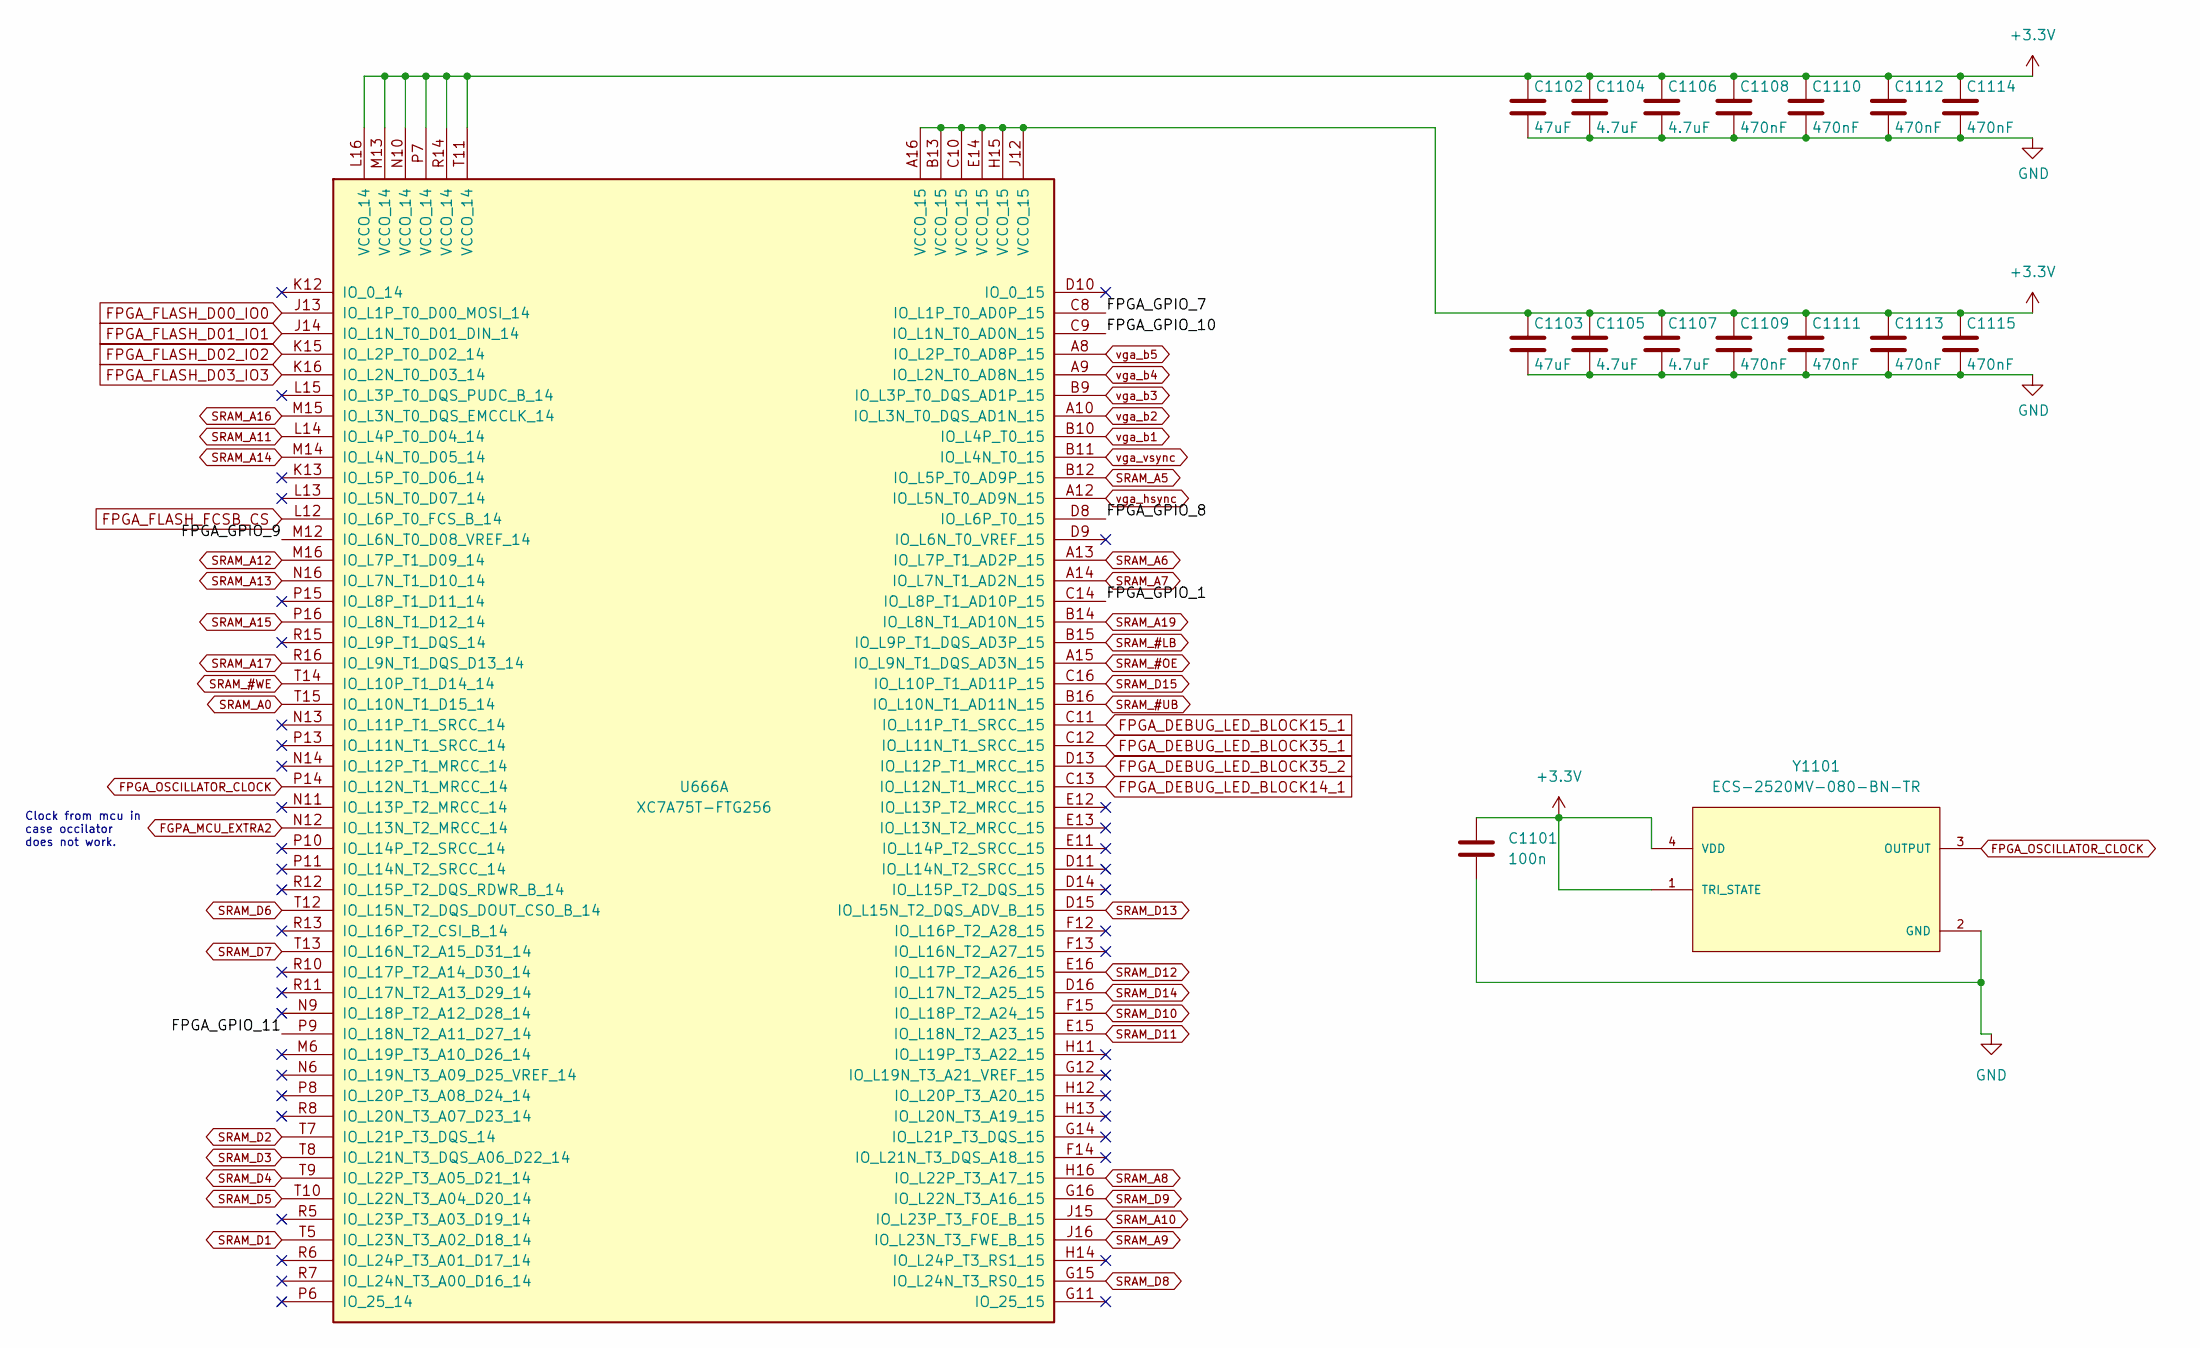
[picture p13: schematic fpga_ua.kicad_sch]

Parts:
C1101: 100n; C_0805_2012Metric_Pad1.18x1.45mm_HandSolder
C1102, C1103: 47uF; C_1210_3225Metric_Pad1.33x2.70mm_HandSolder
C1104, C1105, C1106, C1107: 4.7uF; C_0805_2012Metric_Pad1.18x1.45mm_HandSolder
C1108, C1109, C1110, C1111, C1112, C1113, C1114, C1115: 470nF; C_0603_1608Metric_Pad1.08x0.95mm_HandSolder
U666: XC7A75T-FTG256; Xilinx_FTG256
Y1101: ECS-2520MV-080-BN-TR; OSC_ECS-2520S25-250-FN-TR

Connections:
+3.3V: C1101.1, C1102.1, C1103.1, C1104.1, C1105.1, C1106.1, C1107.1, C1108.1, C1109.1, C1110.1, C1111.1, C1112.1, C1113.1, C1114.1, C1115.1, U666.A16 (VCCO_15), U666.B13 (VCCO_15), U666.C10 (VCCO_15), U666.E14 (VCCO_15), U666.H15 (VCCO_15), U666.J12 (VCCO_15), U666.L16 (VCCO_14), U666.M13 (VCCO_14), U666.N10 (VCCO_14), U666.P7 (VCCO_14), U666.R14 (VCCO_14), U666.T11 (VCCO_14), Y1101.1 (TRI_STATE), Y1101.4 (VDD); also elsewhere on the board
/fpga/fpga ua/FPGA_GPIO_1: U666.C14 (IO_L8P_T1_AD10P_15)
/fpga/fpga ua/FPGA_GPIO_7: U666.C8 (IO_L1P_T0_AD0P_15)
/fpga/fpga ua/FPGA_GPIO_8: U666.D8 (IO_L6P_T0_15)
/fpga/fpga ua/FPGA_GPIO_9: U666.M12 (IO_L6N_T0_D08_VREF_14)
/fpga/fpga ua/FPGA_GPIO_10: U666.C9 (IO_L1N_T0_AD0N_15)
/fpga/fpga ua/FPGA_GPIO_11: U666.P9 (IO_L18N_T2_A11_D27_14)
FGPA_MCU_EXTRA2: U666.N12 (IO_L13N_T2_MRCC_14); also elsewhere on the board
FPGA_DEBUG_LED_BLOCK14_1: U666.C13 (IO_L12N_T1_MRCC_15); also elsewhere on the board
FPGA_DEBUG_LED_BLOCK15_1: U666.C11 (IO_L11P_T1_SRCC_15); also elsewhere on the board
FPGA_DEBUG_LED_BLOCK35_1: U666.C12 (IO_L11N_T1_SRCC_15); also elsewhere on the board
FPGA_DEBUG_LED_BLOCK35_2: U666.D13 (IO_L12P_T1_MRCC_15); also elsewhere on the board
FPGA_FLASH_D00_IO0: U666.J13 (IO_L1P_T0_D00_MOSI_14); also elsewhere on the board
FPGA_FLASH_D01_IO1: U666.J14 (IO_L1N_T0_D01_DIN_14); also elsewhere on the board
FPGA_FLASH_D02_IO2: U666.K15 (IO_L2P_T0_D02_14); also elsewhere on the board
FPGA_FLASH_D03_IO3: U666.K16 (IO_L2N_T0_D03_14); also elsewhere on the board
FPGA_FLASH_FCSB_CS: U666.L12 (IO_L6P_T0_FCS_B_14); also elsewhere on the board
FPGA_OSCILLATOR_CLOCK: U666.P14 (IO_L12N_T1_MRCC_14), Y1101.3 (OUTPUT)
GND: C1101.2, C1102.2, C1103.2, C1104.2, C1105.2, C1106.2, C1107.2, C1108.2, C1109.2, C1110.2, C1111.2, C1112.2, C1113.2, C1114.2, C1115.2, Y1101.2 (GND); also elsewhere on the board
SRAM_#LB: U666.B15 (IO_L9P_T1_DQS_AD3P_15); also elsewhere on the board
SRAM_#OE: U666.A15 (IO_L9N_T1_DQS_AD3N_15); also elsewhere on the board
SRAM_#UB: U666.B16 (IO_L10N_T1_AD11N_15); also elsewhere on the board
SRAM_#WE: U666.T14 (IO_L10P_T1_D14_14); also elsewhere on the board
SRAM_A0: U666.T15 (IO_L10N_T1_D15_14); also elsewhere on the board
SRAM_A5: U666.B12 (IO_L5P_T0_AD9P_15); also elsewhere on the board
SRAM_A6: U666.A13 (IO_L7P_T1_AD2P_15); also elsewhere on the board
SRAM_A7: U666.A14 (IO_L7N_T1_AD2N_15); also elsewhere on the board
SRAM_A8: U666.H16 (IO_L22P_T3_A17_15); also elsewhere on the board
SRAM_A9: U666.J16 (IO_L23N_T3_FWE_B_15); also elsewhere on the board
SRAM_A10: U666.J15 (IO_L23P_T3_FOE_B_15); also elsewhere on the board
SRAM_A11: U666.L14 (IO_L4P_T0_D04_14); also elsewhere on the board
SRAM_A12: U666.M16 (IO_L7P_T1_D09_14); also elsewhere on the board
SRAM_A13: U666.N16 (IO_L7N_T1_D10_14); also elsewhere on the board
SRAM_A14: U666.M14 (IO_L4N_T0_D05_14); also elsewhere on the board
SRAM_A15: U666.P16 (IO_L8N_T1_D12_14); also elsewhere on the board
SRAM_A16: U666.M15 (IO_L3N_T0_DQS_EMCCLK_14); also elsewhere on the board
SRAM_A17: U666.R16 (IO_L9N_T1_DQS_D13_14); also elsewhere on the board
SRAM_A19: U666.B14 (IO_L8N_T1_AD10N_15); also elsewhere on the board
SRAM_D1: U666.T5 (IO_L23N_T3_A02_D18_14); also elsewhere on the board
SRAM_D2: U666.T7 (IO_L21P_T3_DQS_14); also elsewhere on the board
SRAM_D3: U666.T8 (IO_L21N_T3_DQS_A06_D22_14); also elsewhere on the board
SRAM_D4: U666.T9 (IO_L22P_T3_A05_D21_14); also elsewhere on the board
SRAM_D5: U666.T10 (IO_L22N_T3_A04_D20_14); also elsewhere on the board
SRAM_D6: U666.T12 (IO_L15N_T2_DQS_DOUT_CSO_B_14); also elsewhere on the board
SRAM_D7: U666.T13 (IO_L16N_T2_A15_D31_14); also elsewhere on the board
SRAM_D8: U666.G15 (IO_L24N_T3_RS0_15); also elsewhere on the board
SRAM_D9: U666.G16 (IO_L22N_T3_A16_15); also elsewhere on the board
SRAM_D10: U666.F15 (IO_L18P_T2_A24_15); also elsewhere on the board
SRAM_D11: U666.E15 (IO_L18N_T2_A23_15); also elsewhere on the board
SRAM_D12: U666.E16 (IO_L17P_T2_A26_15); also elsewhere on the board
SRAM_D13: U666.D15 (IO_L15N_T2_DQS_ADV_B_15); also elsewhere on the board
SRAM_D14: U666.D16 (IO_L17N_T2_A25_15); also elsewhere on the board
SRAM_D15: U666.C16 (IO_L10P_T1_AD11P_15); also elsewhere on the board
vga_b1: U666.B10 (IO_L4P_T0_15); also elsewhere on the board
vga_b2: U666.A10 (IO_L3N_T0_DQS_AD1N_15); also elsewhere on the board
vga_b3: U666.B9 (IO_L3P_T0_DQS_AD1P_15); also elsewhere on the board
vga_b4: U666.A9 (IO_L2N_T0_AD8N_15); also elsewhere on the board
vga_b5: U666.A8 (IO_L2P_T0_AD8P_15); also elsewhere on the board
vga_hsync: U666.A12 (IO_L5N_T0_AD9N_15); also elsewhere on the board
vga_vsync: U666.B11 (IO_L4N_T0_15); also elsewhere on the board

Notes on the sheet:
Clock from mcu in case occilator does not work.

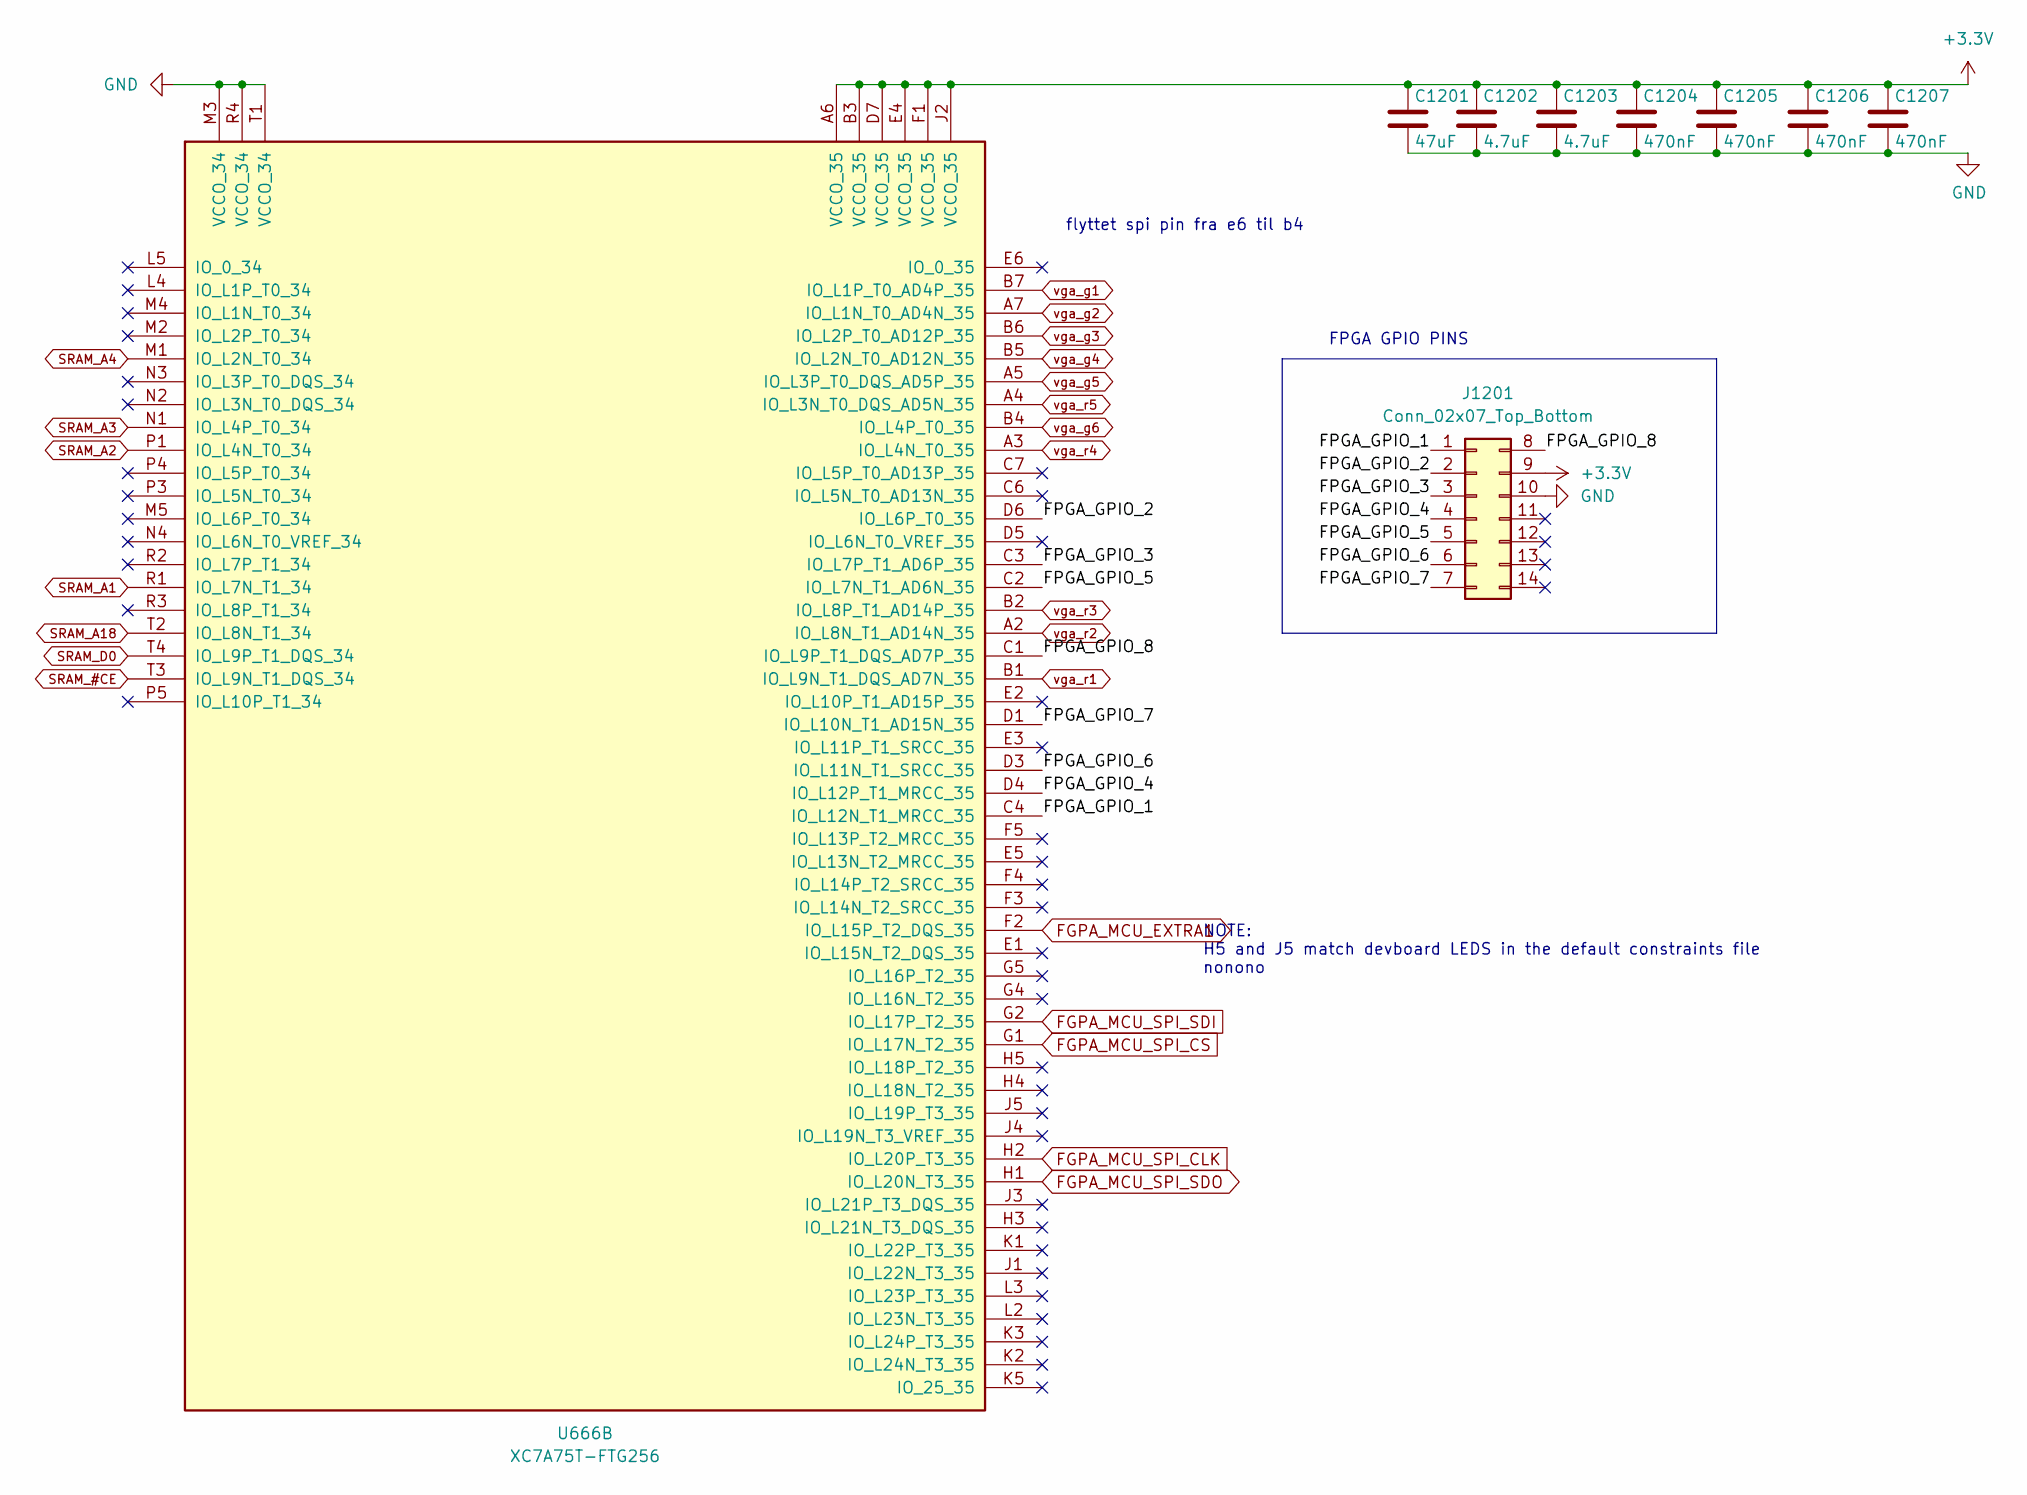
[picture p14: schematic fpga_ub.kicad_sch]

Parts:
C1201: 47uF; C_1210_3225Metric_Pad1.33x2.70mm_HandSolder
C1202, C1203: 4.7uF; C_0805_2012Metric_Pad1.18x1.45mm_HandSolder
C1204, C1205, C1206, C1207: 470nF; C_0603_1608Metric_Pad1.08x0.95mm_HandSolder
J1201: Conn_02x07_Top_Bottom; PinHeader_2x07_P2.54mm_Vertical
U666: XC7A75T-FTG256; Xilinx_FTG256

Connections:
+3.3V: C1201.1, C1202.1, C1203.1, C1204.1, C1205.1, C1206.1, C1207.1, J1201.9, U666.A6 (VCCO_35), U666.B3 (VCCO_35), U666.D7 (VCCO_35), U666.E4 (VCCO_35), U666.F1 (VCCO_35), U666.J2 (VCCO_35); also elsewhere on the board
/fpga/fpga ub/FPGA_GPIO_1: J1201.1, U666.C4 (IO_L12N_T1_MRCC_35)
/fpga/fpga ub/FPGA_GPIO_2: J1201.2, U666.D6 (IO_L6P_T0_35)
/fpga/fpga ub/FPGA_GPIO_3: J1201.3, U666.C3 (IO_L7P_T1_AD6P_35)
/fpga/fpga ub/FPGA_GPIO_4: J1201.4, U666.D4 (IO_L12P_T1_MRCC_35)
/fpga/fpga ub/FPGA_GPIO_5: J1201.5, U666.C2 (IO_L7N_T1_AD6N_35)
/fpga/fpga ub/FPGA_GPIO_6: J1201.6, U666.D3 (IO_L11N_T1_SRCC_35)
/fpga/fpga ub/FPGA_GPIO_7: J1201.7, U666.D1 (IO_L10N_T1_AD15N_35)
/fpga/fpga ub/FPGA_GPIO_8: J1201.8, U666.C1 (IO_L9P_T1_DQS_AD7P_35)
FGPA_MCU_EXTRA1: U666.F2 (IO_L15P_T2_DQS_35); also elsewhere on the board
FGPA_MCU_SPI_CLK: U666.H2 (IO_L20P_T3_35); also elsewhere on the board
FGPA_MCU_SPI_CS: U666.G1 (IO_L17N_T2_35); also elsewhere on the board
FGPA_MCU_SPI_SDI: U666.G2 (IO_L17P_T2_35); also elsewhere on the board
FGPA_MCU_SPI_SDO: U666.H1 (IO_L20N_T3_35); also elsewhere on the board
GND: C1201.2, C1202.2, C1203.2, C1204.2, C1205.2, C1206.2, C1207.2, J1201.10, U666.M3 (VCCO_34), U666.R4 (VCCO_34), U666.T1 (VCCO_34); also elsewhere on the board
SRAM_#CE: U666.T3 (IO_L9N_T1_DQS_34); also elsewhere on the board
SRAM_A1: U666.R1 (IO_L7N_T1_34); also elsewhere on the board
SRAM_A2: U666.P1 (IO_L4N_T0_34); also elsewhere on the board
SRAM_A3: U666.N1 (IO_L4P_T0_34); also elsewhere on the board
SRAM_A4: U666.M1 (IO_L2N_T0_34); also elsewhere on the board
SRAM_A18: U666.T2 (IO_L8N_T1_34); also elsewhere on the board
SRAM_D0: U666.T4 (IO_L9P_T1_DQS_34); also elsewhere on the board
vga_g1: U666.B7 (IO_L1P_T0_AD4P_35); also elsewhere on the board
vga_g2: U666.A7 (IO_L1N_T0_AD4N_35); also elsewhere on the board
vga_g3: U666.B6 (IO_L2P_T0_AD12P_35); also elsewhere on the board
vga_g4: U666.B5 (IO_L2N_T0_AD12N_35); also elsewhere on the board
vga_g5: U666.A5 (IO_L3P_T0_DQS_AD5P_35); also elsewhere on the board
vga_g6: U666.B4 (IO_L4P_T0_35); also elsewhere on the board
vga_r1: U666.B1 (IO_L9N_T1_DQS_AD7N_35); also elsewhere on the board
vga_r2: U666.A2 (IO_L8N_T1_AD14N_35); also elsewhere on the board
vga_r3: U666.B2 (IO_L8P_T1_AD14P_35); also elsewhere on the board
vga_r4: U666.A3 (IO_L4N_T0_35); also elsewhere on the board
vga_r5: U666.A4 (IO_L3N_T0_DQS_AD5N_35); also elsewhere on the board

Notes on the sheet:
NOTE: H5 and J5 match devboard LEDS in the default constraints file nonono
FPGA GPIO PINS
flyttet spi pin fra e6 til b4

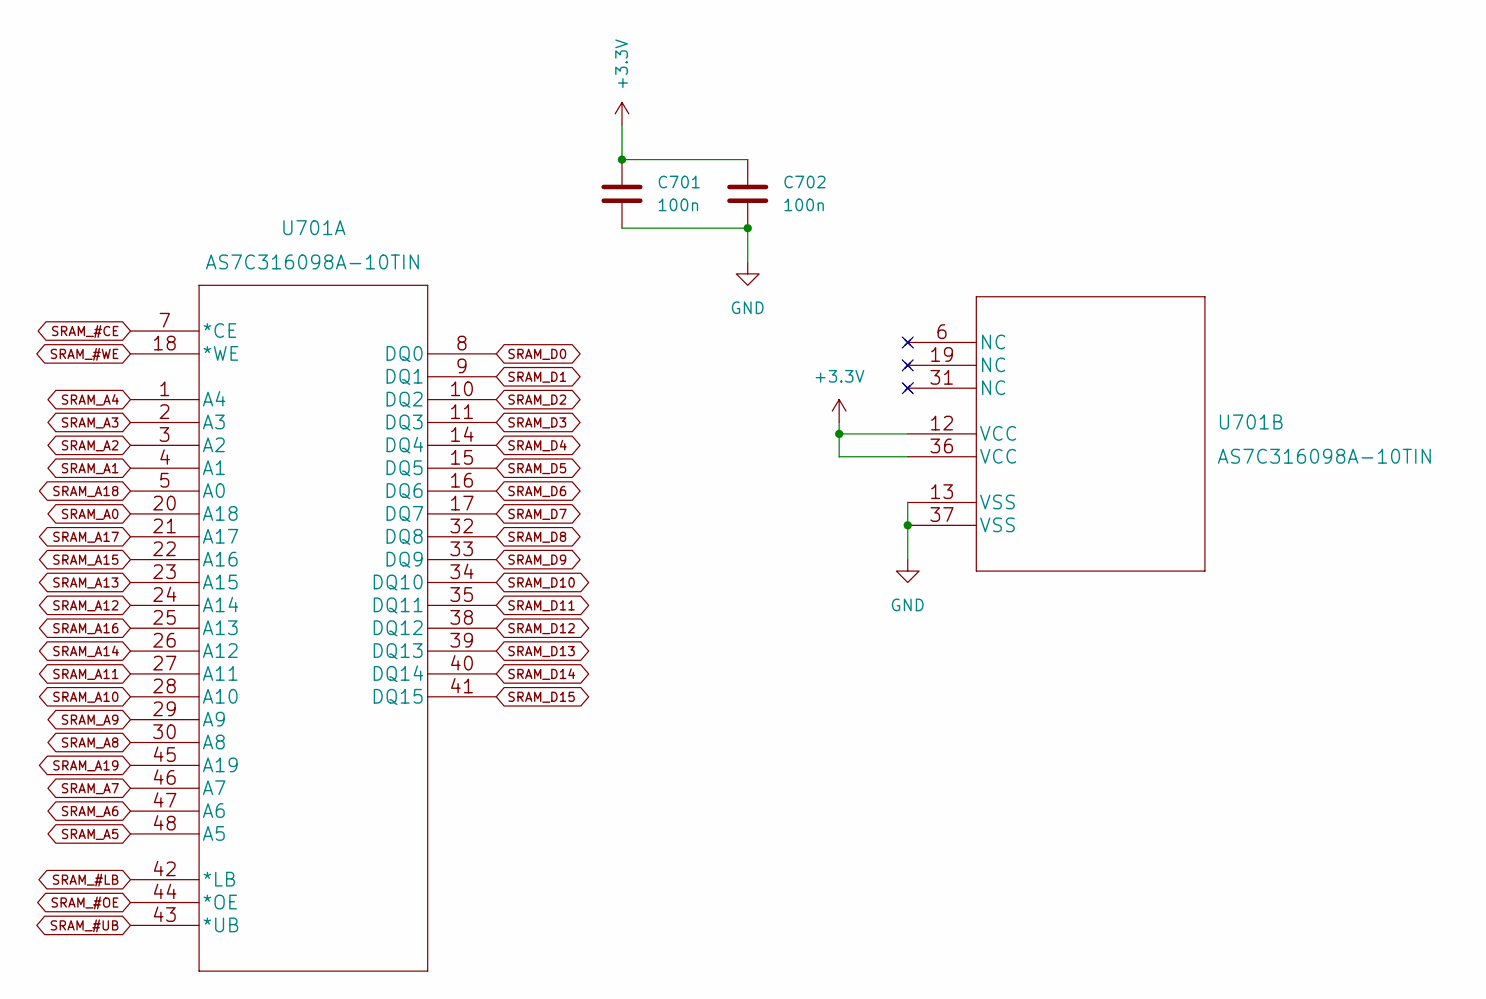
[picture p15: schematic sram.kicad_sch]

Parts:
C701, C702: 100n; C_0805_2012Metric_Pad1.18x1.45mm_HandSolder
U701: AS7C316098A-10TIN

Connections:
+3.3V: C701.2, C702.2, U701.12 (VCC), U701.36 (VCC); also elsewhere on the board
GND: C701.1, C702.1, U701.13 (VSS), U701.37 (VSS); also elsewhere on the board
SRAM_#CE: U701.7 (*CE); also elsewhere on the board
SRAM_#LB: U701.42 (*LB); also elsewhere on the board
SRAM_#OE: U701.44 (*OE); also elsewhere on the board
SRAM_#UB: U701.43 (*UB); also elsewhere on the board
SRAM_#WE: U701.18 (*WE); also elsewhere on the board
SRAM_A0: U701.20 (A18); also elsewhere on the board
SRAM_A1: U701.4 (A1); also elsewhere on the board
SRAM_A2: U701.3 (A2); also elsewhere on the board
SRAM_A3: U701.2 (A3); also elsewhere on the board
SRAM_A4: U701.1 (A4); also elsewhere on the board
SRAM_A5: U701.48 (A5); also elsewhere on the board
SRAM_A6: U701.47 (A6); also elsewhere on the board
SRAM_A7: U701.46 (A7); also elsewhere on the board
SRAM_A8: U701.30 (A8); also elsewhere on the board
SRAM_A9: U701.29 (A9); also elsewhere on the board
SRAM_A10: U701.28 (A10); also elsewhere on the board
SRAM_A11: U701.27 (A11); also elsewhere on the board
SRAM_A12: U701.24 (A14); also elsewhere on the board
SRAM_A13: U701.23 (A15); also elsewhere on the board
SRAM_A14: U701.26 (A12); also elsewhere on the board
SRAM_A15: U701.22 (A16); also elsewhere on the board
SRAM_A16: U701.25 (A13); also elsewhere on the board
SRAM_A17: U701.21 (A17); also elsewhere on the board
SRAM_A18: U701.5 (A0); also elsewhere on the board
SRAM_A19: U701.45 (A19); also elsewhere on the board
SRAM_D0: U701.8 (DQ0); also elsewhere on the board
SRAM_D1: U701.9 (DQ1); also elsewhere on the board
SRAM_D2: U701.10 (DQ2); also elsewhere on the board
SRAM_D3: U701.11 (DQ3); also elsewhere on the board
SRAM_D4: U701.14 (DQ4); also elsewhere on the board
SRAM_D5: U701.15 (DQ5); also elsewhere on the board
SRAM_D6: U701.16 (DQ6); also elsewhere on the board
SRAM_D7: U701.17 (DQ7); also elsewhere on the board
SRAM_D8: U701.32 (DQ8); also elsewhere on the board
SRAM_D9: U701.33 (DQ9); also elsewhere on the board
SRAM_D10: U701.34 (DQ10); also elsewhere on the board
SRAM_D11: U701.35 (DQ11); also elsewhere on the board
SRAM_D12: U701.38 (DQ12); also elsewhere on the board
SRAM_D13: U701.39 (DQ13); also elsewhere on the board
SRAM_D14: U701.40 (DQ14); also elsewhere on the board
SRAM_D15: U701.41 (DQ15); also elsewhere on the board

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
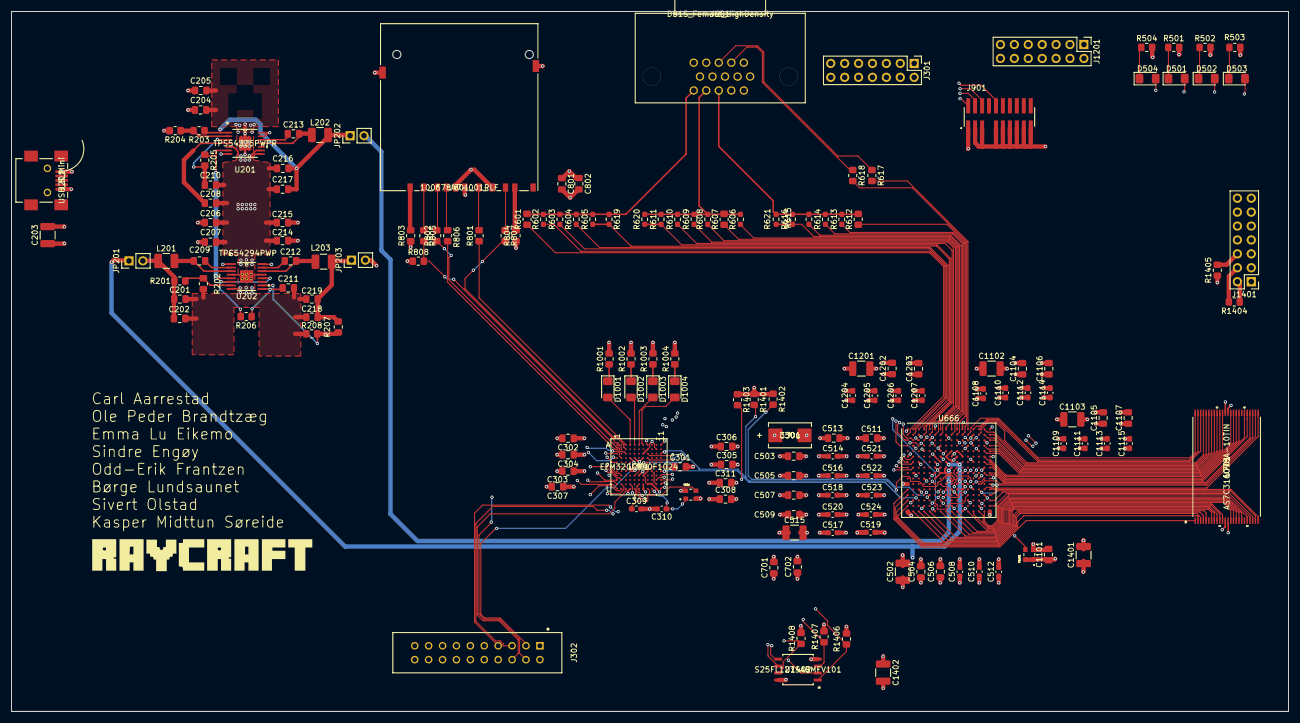
[picture p16: board pcb.kicad_pcb from above]

Board: 6 copper layers, 233.3 x 127.9 mm, 165 parts (0 on the bottom side), 166 nets.
