TDT4295AForEffort/pcb/(commit log)

2022-09-14 begin work on pcb
    [pcb.kicad_pcb, pcb.kicad_sch, psu.kicad_sch]
2022-09-14 add mcu sheet with finished debug connector
    [mcu.kicad_sch, pcb.kicad_sch]
2022-09-14 more work on psu
    [psu.kicad_sch]
2022-09-16 more mcu
    [mcu.kicad_sch, pcb.kicad_sch]
2022-09-16 finish wiring
    [psu.kicad_sch]
2022-09-16 add global labels and footprint
    [mcu.kicad_sch]
2022-09-16 finish psu(maybe???)
    [psu.kicad_sch]
2022-09-17 add component values
    [psu.kicad_sch]
2022-09-17 io_controller_inputs on mcu
    [mcu.kicad_sch]
2022-09-17 finish onboard controller
    [COM-09032.step, mcu.kicad_sch, onboard_controller.kicad_sch]
2022-09-17 begin adding fpga
    [fpga.kicad_sch, fpga_ua.kicad_sch, fpga_ub.kicad_sch, fpga_uc.kicad_sch, fpga_ud.kicad_sch]
2022-09-17 add flash memory component for fpga
    [fpga.kicad_sch, fpga_ua.kicad_sch, fpga_ub.kicad_sch, fpga_uc.kicad_sch, fpga_ud.kicad_sch]
2022-09-17 oops I think I updated these
    [pcb.kicad_sch]
2022-09-17 add externall controller
    [controller.kicad_pcb, controller.kicad_sch, mcu.kicad_sch]
2022-09-17 kicad said I needed to save
    [fpga.kicad_sch, fpga_ua.kicad_sch, fpga_ub.kicad_sch, fpga_uc.kicad_sch, fpga_ud.kicad_sch, mcu.kicad_sch, onboard_controller.kicad_sch, pcb.kicad_sch]
2022-09-17 add spi pins and finish onboard_controller
    [mcu.kicad_sch, onboard_controller.kicad_sch]
2022-09-18 finish mcu :-)
    [mcu.kicad_sch, onboard_controller.kicad_sch]
2022-09-18 add jtag connector and flash to fpga
    [fpga.kicad_sch, fpga_uc.kicad_sch, psu.kicad_sch]
2022-09-19 fpga shite
    [fpga.kicad_sch, fpga_ua.kicad_sch, fpga_uc.kicad_sch, fpga_ud.kicad_sch]
2022-09-19 add vga
    [mcu.kicad_sch]
2022-09-19 added new_vga and sram
    [fpga.kicad_sch, fpga_ua.kicad_sch, fpga_uc.kicad_sch, fpga_ud.kicad_sch, mcu.kicad_sch, onboard_controller.kicad_sch, pcb.kicad_sch, sram.kicad_sch]
2022-09-20 connect sram and vga to fpga
    [fpga_ua.kicad_sch, mcu.kicad_sch, sram.kicad_sch, vga.kicad_sch]
2022-09-20 add capasitor values
    [mcu.kicad_sch]
2022-09-20 add capasitro values again
    [mcu.kicad_sch, pcb.kicad_sch]
2022-09-22 add missing values again
    [fpga_uc.kicad_sch, fpga_ud.kicad_sch, mcu.kicad_sch, pcb.kicad_sch]
2022-09-22 commit before merge
    [fpga.kicad_sch, fpga_ua.kicad_sch, fpga_uc.kicad_sch, psu.kicad_sch]
2022-09-27 maybe finished schematic
    [MCU_DEBUG.kicad_sch, MCU_DEBUG_LEDS.kicad_sch, fpga.kicad_sch, fpga_ua.kicad_sch, fpga_uc.kicad_sch, mcu.kicad_sch, pcb.kicad_sch, psu.kicad_sch]
2022-09-28 everything except crystal
    [fpga.kicad_sch, fpga_ua.kicad_sch, mcu.kicad_sch, pcb.kicad_sch, sd.kicad_sch, sram.kicad_sch]
2022-09-29 add oscilattor + spi debug+ cap on sramd
    [fpga_ua.kicad_sch, fpga_ub.kicad_sch, mcu.kicad_sch, pcb.kicad_sch, sram.kicad_sch]
2022-09-29 add footprints
    [MCU_DEBUG.kicad_sch, MCU_DEBUG_LEDS.kicad_sch, fpga.kicad_sch, fpga_ua.kicad_sch, fpga_ub.kicad_sch, fpga_uc.kicad_sch, fpga_ud.kicad_sch, mcu.kicad_sch]
2022-09-29 add footprints + fix unnconnected
    [CX3225SB48000D0FFFCC.step, FTSH-110-01-L-DV-007.step, MCU_DEBUG.kicad_sch, fpga.kicad_sch, fpga_ua.kicad_sch, fpga_ub.kicad_sch, fpga_uc.kicad_sch, fpga_ud.kicad_sch]
2022-09-30 start layout
    [COM-09032.step, MCU_DEBUG.kicad_sch, fpga.kicad_sch, fpga_ua.kicad_sch, fpga_ub.kicad_sch, fpga_uc.kicad_sch, fpga_ud.kicad_sch, mcu.kicad_sch]
2022-09-30 connect onboard controller
    [fpga.kicad_sch, fpga_uc.kicad_sch, fpga_ud.kicad_sch, pcb.kicad_pcb, pcb.kicad_sch]
2022-10-01 fix nasty shorts
    [fpga_ud.kicad_sch]
2022-10-01 more traces
    [pcb.kicad_pcb]
2022-10-01 add power input
    [psu.kicad_sch]
2022-10-01 change footprint of connector
    [mcu.kicad_sch, pcb.kicad_pcb]
2022-10-01 add pcb file oops
    [pcb.kicad_sch]
2022-10-01 add footprint to usb
    [pcb.kicad_sch, psu.kicad_sch]
2022-10-01 change footprint of debug_connector
    [MCU_DEBUG.kicad_sch, fpga_ua.kicad_sch, fpga_uc.kicad_sch, fpga_ud.kicad_sch, pcb.kicad_pcb, pcb.kicad_sch, psu.kicad_sch]
2022-10-01 switch some pins for more erqonomiq layout
    [MCU_DEBUG.kicad_sch, fpga_ua.kicad_sch, fpga_uc.kicad_sch, mcu.kicad_sch, pcb.kicad_pcb, pcb.kicad_sch]
2022-10-01 add/fix sd,usb,flash footprints
2022-10-01 assign the last footprints
    [fpga_uc.kicad_sch, pcb.kicad_sch, psu.kicad_sch, sd.kicad_sch]
2022-10-02 fix vga resistors
    [fpga_ub.kicad_sch, mcu.kicad_sch, pcb.kicad_sch, vga.kicad_sch]
2022-10-02 fix joystick
    [fpga_ub.kicad_sch, mcu.kicad_sch, onboard_controller.kicad_sch, pcb.kicad_sch, vga.kicad_sch]
2022-10-02 deconect shield on joystick
    [onboard_controller.kicad_sch]
2022-10-02 psu wiring and power cables
    [fpga_ua.kicad_sch, pcb.kicad_pcb, pcb.kicad_sch, psu.kicad_sch, vga.kicad_sch]
2022-10-02 add correct vga resistors
    [fpga_ua.kicad_sch, pcb.kicad_pcb, pcb.kicad_sch, vga.kicad_sch]
2022-10-02 change location of stram pin
    [fpga_ua.kicad_sch]
2022-10-02 make lines between sram and fpga
    [fpga.kicad_sch, fpga_ua.kicad_sch, fpga_ub.kicad_sch, fpga_uc.kicad_sch, fpga_ud.kicad_sch, mcu.kicad_sch, onboard_controller.kicad_sch, pcb.kicad_pcb]
2022-10-02 move capasitor
    [pcb.kicad_pcb]
2022-10-02 add 1.0v and 1.8v decoupling for fpga, clean capacitors
    [pcb.kicad_pcb]
2022-10-02 vga is live
    [fpga.kicad_sch, fpga_ua.kicad_sch, fpga_ub.kicad_sch, fpga_uc.kicad_sch, fpga_ud.kicad_sch, mcu.kicad_sch, onboard_controller.kicad_sch, pcb.kicad_pcb]
2022-10-03 decouple fpga, clean up a bit
    [pcb.kicad_pcb]
2022-10-03 is donegst
    [fpga_ua.kicad_sch, fpga_ub.kicad_sch, fpga_uc.kicad_sch, mcu.kicad_sch, pcb.kicad_pcb, pcb.kicad_sch]
2022-10-03 fix capacitor values and footprints
    [fpga.kicad_sch, fpga_ua.kicad_sch, fpga_uc.kicad_sch, pcb.kicad_sch, sd.kicad_sch, sram.kicad_sch, vga.kicad_sch]
2022-10-03 fix edge + fills
    [pcb.kicad_pcb]
2022-10-03 creeper? aw man
    [pcb.kicad_pcb]
2022-10-03 fix some schematic erc errors
    [fpga.kicad_sch, fpga_ua.kicad_sch, fpga_ub.kicad_sch, fpga_uc.kicad_sch, fpga_ud.kicad_sch, mcu.kicad_sch, onboard_controller.kicad_sch, psu.kicad_sch]
2022-10-03 replace jumpers with pin headers
    [pcb.kicad_pcb, pcb.kicad_sch, psu.kicad_sch]
2022-10-03 fix new vga
    [fpga.kicad_sch, fpga_uc.kicad_sch, fpga_ud.kicad_sch, mcu.kicad_sch, onboard_controller.kicad_sch, pcb.kicad_pcb, pcb.kicad_sch, psu.kicad_sch]
2022-10-04 fix errors in schematic
    [fpga_uc.kicad_sch, mcu.kicad_sch, pcb.kicad_sch, psu.kicad_sch]
2022-10-04 up via size, going to remove onboard-controller
    [pcb.kicad_pcb]
2022-10-04 fix vias
    [fpga.kicad_sch, fpga_uc.kicad_sch, mcu.kicad_sch, onboard_controller.kicad_sch, pcb.kicad_pcb, pcb.kicad_sch, psu.kicad_sch, sd.kicad_sch]
2022-10-04 fix psu
    [pcb.kicad_pcb]
2022-10-04 is donegit !
    [pcb.kicad_pcb]
2022-10-04 cleanup vias etc
    [pcb.kicad_pcb]
