TDT4295AForEffort/pcb/(notices)

Notices in the files:
components/debug_header/FTSH-110-01-L-DV-007.step:
author */ ('License CC BY-ND 4.0'),
parts and their libraries:
Copyright 2021 Accelerated Designs. All rights reserved.
